RamsesKlap/FinalThesis/Lõputöö/Mõõtmed.md

# Jitter ehk sageduse variatsioon
- Temp: u 29kraadi
- Mõõtmise pikkus: 5 min
- 1. sagedus: 440-441 Hz ca C4
- 2. sagedus: 1864 Hz ca A#6
- 3. sagedus: 20 Hz

# Note on/off speed
- Temp: sama
- Mõõtmisi: 25
