RamsesKlap/FinalThesis/Lõputöö/Koosolekud/K7 - 09.09.25.md

Vaata üle mis skaalal oli PWM sisend VCO-l
Pane pote ENV 1 ja 2 otsa, et saaks ilma ADSRita proovida

Teaduste öö olla kaks viimast töötuba, 14+ vanus

### Õppeassistent
- E-lab
	- date peaks olema 21. sept
- Nimeta LABid üle uut moodi
- Lab1
	- küsimuste vastamise vaata üle, et see töötaks
	- Saab korduvalt vastata
	- Punktisummad
	- Pane küsimused eraldi lehtedele ka

880
860
840
293.3
286.6
280
