RamsesKlap/FinalThesis/Lõputöö/Elektroonika/VCO.md

#Siinus #Nelinurk #Saehammas #Kolmnurk #Summeerimine 

------------------
# Signaaligeneraator
*Miks?*
- Selleks, et heli tekitada
- nö südamik

*Millised?*
- **Kokku:** 10
- Siinus+
- Kolmnurk+
- Saehammas+
- Nelinurk+
- **Kombod:** 
	- Siinus + Kolmnurk+
	- Kolmnurk + Saehammas+
	- Saehammas + Nelinurk+
	- Nelinurk + Siinus+
	- Siinus + Saehammas
	- Kolmnurk + Nelinurk+
	- Valimine toimub [[Waveform Select]]is

*Valikud:*
- [AS3340](https://www.ericasynths.lv/shop/ics/voltage-controlled-oscillator-as3340/)
	- *5 €/tk* (SOIC) või *10 €/tk* (PDIP)
	- All-in-one (va siinus)
	- Temp. stabiilsus hea
	- Töötab kahepolaarse toitel
	- Läti toode :D
	- *Signal amplitudes*
		- Triangle - 1/3 of the supply (12 V -> 4 V)
		- Sawtooth - 2/3 of the supply (12 V -> 8 V)
		- Pulse - 1,5 V below the supply (12 V -> 10,5 V)1
# Coarse + Fine tuning
+ Kasutada digitaalpotentsiomeetreid, et saaks softis seda reguleerida
+ Lisab "manual override" juhul kui see ei tööta nii hästi

----------
### Signaali suund: [[Waveform Select]]
