RamsesKlap/FinalThesis/Lõputöö/Koosolekud/Küsimused.md

**LFO**
- Kas kombineerida LFO kiirus ja amplituud ühe rotary encoder peale või mitte?

**VCO**
- Kas rotary encoder + binary counter + mux on mõistlik signaalide valimiseks?
- Kas clocki delay-ima mingil määral, et kindlaks teha, et D on on seadustatud enne clocki tõusmist?
- Kas oskad midagi rääkida OTA-dest? Kas on mõistlik valik? (LM13700)

**Misc.**
- Kas on mõistlik lisada digipoted ja tavalised poted asjade reguleerimiseks (nt häälestamine, pitch bend jne), et oleks võimalik seda softis ja manuaalselt muute?

## K7 küsimused
- Ma leidsin Erica Synths-i poolt koostatud ADSR, VCF, VCA ja VCO kiibid, mis tunduvad päris head. Kas kasutada kõike või ainult näiteks VCA ja VCO-d?
	- [VCF](https://www.ericasynths.lv/shop/ics/voltage-controlled-filter-3109/)
		- Sama arhitektuur kui see MS-20 filter
		- Saab kahte kanalit ühe kiibi alla panna
		- 2xOTA on *0,99 €/tk* (LM13700) ning kiip ise on *4,50 €/tk*
		- Kas see kiip oleks soodsam/mõistlikum kui ise kokku panna?
	- [VCA](https://www.ericasynths.lv/shop/ics/voltage-controlled-amplifier-as3360/)
	- [ADSR](https://www.ericasynths.lv/shop/ics/voltage-controlled-envelope-generator-as3310/)
