RamsesKlap/FinalThesis/Lõputöö/Koosolekud/K6 - 17.06.25.md

Jaga Kaiserile skeemid zipidena

Lugemiseks kui viitsin:
- PCB Stackup (4&6 kihilistele)
- Via stub
- Return path
- Gnd via signaali via kõrvale, et ta sidestuks sellega

Kirjelda board stackupi aruandes

Proovi mõningaid asju jätta projektiainete jaoks

# Õppeassistent
- Drag and drop image asi toiteploki jaoks
- 0.25 ühikutrahv
-
