RamsesKlap/FinalThesis/Lõputöö/Koosolekud/K1 - 20.11.24.md

Vaata tugipingeallikaid, mis oleksid sweetspotis

Toide oleks pigem parem võtta AC-AC adapter, kui vool on suurem kui 10-20 mA
Kui väiksem, siis saab virtual groundiga

Talle väga meeldis, et ma standardist rääkisin :)

DACi sampling frequency kohta võib uurida hiirte kohta ja nende sagedustest
