RamsesKlap/FinalThesis/Lõputöö/Koosolekud/K3 - 17.03.25.md

*Elektroonika*
- MCU võta pigem 10 pinine kõige rohkema mäluga
	- Vaata äkki panna samale boardile 64 ja 100-ne (footprindid üksteise sisse nt)
	- Vaata mehaanilist mõõtu esialgu ja siis pinout
- DAC ja ADC valiku uurimine
	- Kas piisavalt kiire / hea sampling rate?
	- Teegid?
- Alusta "interface" blokkist
- Toide
	- Tee eraldi toite flowchart
	- Vaata kas asjad saaksid kaetud (teoorias)

## Elektroonika aine
6 ja 7 enesekontrolli testid
- Teen küsimused juurde äkki
Lab1 ja 2
- Proovida neid läbi koos juhenditega
- Mis puudu, mis võiks paremini teha?
