RamsesKlap/FinalThesis/Lõputöö/Koosolekud/K4 - 07.04.25.md

# ADC
- Vaata mis mõjutavad sampling rate'i (toitepinge, temperatuur vms)
	- Sampling rate ei ole muidugi ideaalne, mingid parameetrid sellel ongi
- Vaata äkki mingi aeglasem variant ka
	- Pane PCB-le kaks ADC-d. Üks kiirem üks aeglasem
- Uuri kas äkki kasutada lihtsalt 1 ADC per membrane (eraldi)

# DAC
- Vaata kas keegi tahaks teeki teha selle uhke teegi jaoks nt lõputööks

## Misc.
- Testi thinpoti reageerimist ja kas see teeb open connectionit
- Uuri FPGA-d
## Soovid
- Vaata, et liiga paljuks ei lähe
