RamsesKlap/FinalThesis/Lõputöö/Koosolekud/K5 - 03.06.25.md

# Uuri
- Lag / Jitter / Faas
	- Kuidas mõõdame?
	- "Propagation delay"
	- Tee terminoloogia selgeks
	- Kuidas tuvastada / mõõta?
		- Kvantitatiivselt suuta asjad paika panna
	- 

Hea et uurisin reageerimisaegu reageerimisaja kohta. Sellest võiks töös rääkida.

# Gantt
- Suur tükk ajab suu lõhki
- Dets / Jaanuar **Riisvara võiks olla küps**
- Võibolla mõelda, mis on ülikriitiline mida lahendada
- **Color Coding vastavalt diagrammile**

Alati kui mingi valiku teen, siis see peab mingi alusel olema selgitatud
Kriteeriumid!!!

Pane plokki alla alamplokkid

Kirjutada Ellervee / Eekile kas keegi tahab teeke kirjutada

Pane plokkskeem excelli

MVP - Sisend, VCO ja VCA
Baka töös pmst fokuseerida nendele vist

1. sissejuhatus
2. State of the art
3. Simukad / Valikute põhjendamine / Trükkplaadi v Skeemi tegemine
4. Mõõtmine
5. Kokkuvõte

Koosolekud võiks teha 2 nädalaste vahedega

# Aniõppejõud
- Sandbox
	- Finalize
	- Laborite osas peab tekkima 4
	- Edenemisskaalad eraldi teha (Nagu elektroonikas)
- Juhendid
	- Eestikeeles juhendid olemas
	- Inglisekeeles pole
	- Võiksin esmase tõlke teha nende jaoks
		- e-lab
		- arduino
			- Võiks sellele teha vormi, millele vastavad aruannet lugedes
			- Moodle'i vormi selles suhtes
		- Diood ja transa labor
			- Ideaalselt samasugune labor
		- Opvõimendi laborid
		- Jootelabor
