RamsesKlap/FinalThesis/Lõputöö/Koosolekud/K2 - 10.02.25.md

# Rotary encoder selector
- Deboucer lisada
## Asjad mida teha
- Võta ette lõputöö mall
- Oma nägemuse järgi pane peatükkitele nimed
	- ala state of the art
		- Lõppu üleasande/probleemi püstitus
		- 2-3 lauset mis paneb selle paika
		- "Tehti nii, ma teeks nii/muudaks seda"
	- sims
	- skeem 
	- riistvara
	- kood
	- testimine
	- kokkuvõte
	- jne
- Hakka väikest mulli looma
- Vb uuri mis riistvara enam vähem paigas (nt prose)

# Toide
- Uuri low noise teemat
- Uuri trafosid ja olemasolevaid lahendusi
