RamsesKlap/FinalThesis/KiCad/ModulinV2/ModulinV2_amounts2.csv

Qty | Value
107 | 100n
71 | 1u
2 | 2p
4 | 2u2
13 | 10n
13 | 3n
2 | 22p
3 | 1m
4 | 100u
1 | CDBU0530
4 | 1N4148WT
2 | 1N5822
1 | SF-1206F100-2
6 | TL074HIDR
1 | STM32F401RET6
1 | USBLC6-2SC6
7 | TL072HIDR
2 | ADS7041IDCUR
2 | ADS7866IDBVT
2 | DAC60501ZDGSR
2 | AS3340D
3 | SN74LV10ADR
2 | SN74HC193DR
3 | TMUX4051DYYRQ1
1 | NC7SZ74K8X
3 | SN74AHCT1G00DBVR
2 | SN74AHC1G02DBVR
1 | TMUX4052DYYR
2 | E-ULN2003D1013TR
2 | CD4028BM96
1 | AS3360D
1 | REF196GSZ-REEL
2 | NCP5500DADJR2G
2 | LM2576S-12_NOPB
1 | REF195ESZ-REEL
2 | L7812CD2T-TR
2 | AS3310D
1 | DAC53202RTER
2 | AS3320D
1 | NRJ4HF-1
1 | USB4105-GF-A
1 | TSM-103-01-T-DV
1 | TSW-104-07-G-S
4 | TSW-104-07-T-D
1 | PJ-002B
1 | Output bypass1
1 | Output bypass2
2 | ADSR_BYPASS1
1 | OLED_PWR
2 | Pot GND
2 | Attack override
2 | Decay override
2 | Sustain override
2 | Release override
1 | VCF_BYPASS1
1 | VCF_BYPASS2
2 | 68u
2 | 20u
1 | 150212M173123
14 | 150060RS75000
4 | 150060VS75000
2 | MMBFJ201
1 | DMP610DL-7
41 | 10k
24 | 100k
6 | 5k1
28 | 1k
14 | 20k
2 | 200k
11 | 1M
14 | 470
2 | 360k
1 | 1M5
2 | 24k
2 | 5k6
2 | 620
2 | 2k4
4 | 1k2
2 | 220k
4 | 47k
8 | 2k
2 | 30k
6 | 22k
6 | 51k
2 | 68k
2 | 1k8
2 | EXB-2HV102JV
2 | TL3365AF180QG
2 | PEC12R-3220F-S0024
2 | EG4208A
1 | OS102011MS2QS1
1 | SW_SPDT_MSM
1 | Rocker Switch
1 | BendTop
1 | Final
1 | VBUS
1 | ENCA
1 | SDA1
1 | SCL1
1 | SDA2
1 | ENCB
1 | SCL2
1 | CLK2
1 | MOSI2
1 | CS2.1
1 | CS2.2
1 | CLK1
1 | MISO1
1 | CS1.1
1 | CS1.2
1 | CLK3
1 | MISO3
1 | MOSI3
1 | CS3
1 | Press1.1
1 | Pitch1
1 | Pitch2
1 | Press1.2
1 | Pot1
1 | Pot2
1 | Gate1
1 | Press1.3
1 | Press2.1
1 | Press2.2
1 | Gate2
1 | Press2.3
1 | +2V
1 | +1V
1 | SW1
1 | SW2
1 | +4V
1 | +3V
1 | Oct
1 | !Q
1 | Enc_B
1 | Q
1 | Up
1 | Down
1 | Enc_A
1 | Wave1
1 | VCA1
1 | Wave2
1 | VCA2
1 | 3v3
1 | 3v3A
1 | VDC
1 | +12V
1 | -12V
1 | 5V
1 | 5VA
1 | ADigital
1 | DDigital
1 | SDigital
1 | RDigital
1 | Attack
1 | Decay
1 | Sustain
1 | Release
1 | ENV1
1 | ENV2
1 | C1Digital
1 | C2Digital
1 | F1Digital
1 | F2Digital
1 | Coarse1
1 | Coarse2
1 | Fine1
1 | Fine2
1 | LFO1
1 | LFO2
1 | LFO_INV
1 | LFO
1 | VCF1
1 | RES1
1 | CUT1
1 | RES2
1 | VCF2
1 | CUT2
1 | SN74AHC1G08DBVR
1 | PTA4543-2015CPB104
1 | PTA4544-2015DPA103
10 | PTV09A-4025F-B104
8 | DS3502U+
2 | PTV112-4420A-B104
1 | CX2016FB24000B0FZZH1
