RamsesKlap/FinalThesis/KiCad/ModulinV2/Footprints/MCU/STM32F401VET6/LQFP100-14x14mm.step

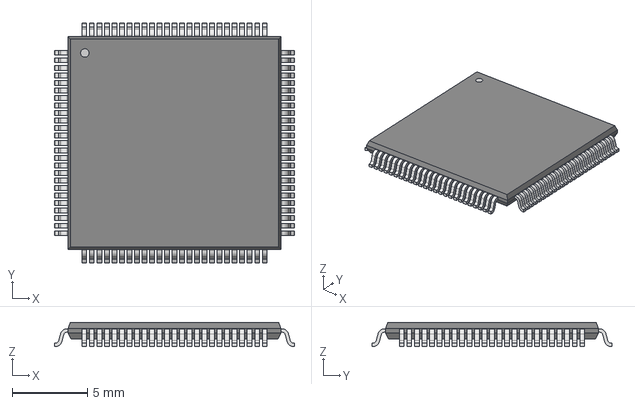
[picture p1: CAD file, 2025-04-27]
KiCad/ModulinV2/Footprints/MCU/STM32F401VET6/LQFP100-14x14mm.step
16.0 x 16.0 x 1.60 mm
