RamsesKlap/FinalThesis/Measurements/20Hz_jitter_1.png

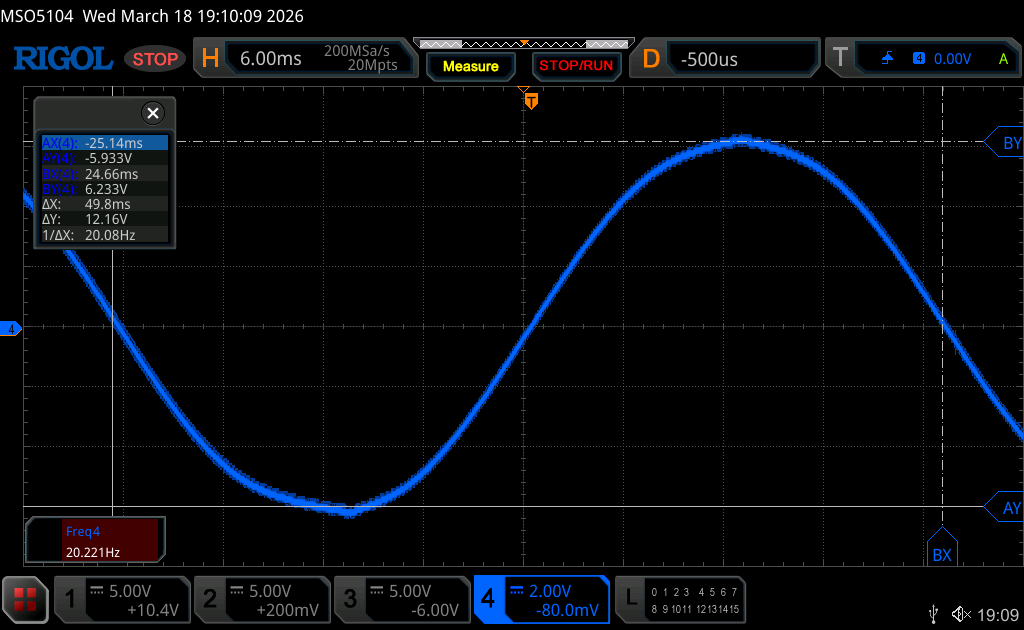
Measurements/20Hz_jitter_1.png
