RamsesKlap/FinalThesis/Measurements/A#6_jitter_1.png

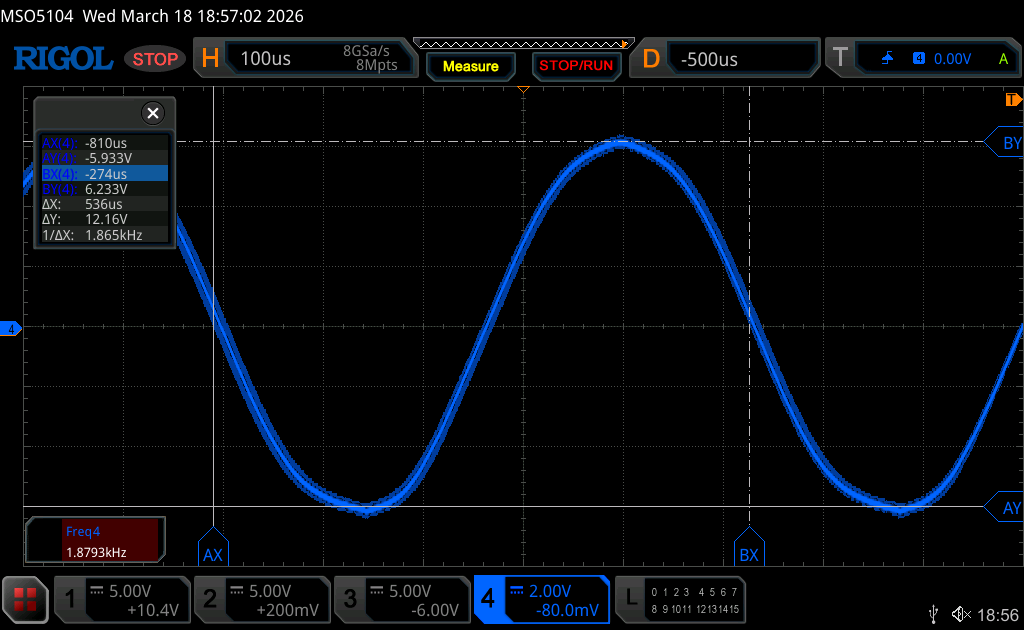
Measurements/A#6_jitter_1.png
