RamsesKlap/FinalThesis/Measurements/C4_jitter_1.png

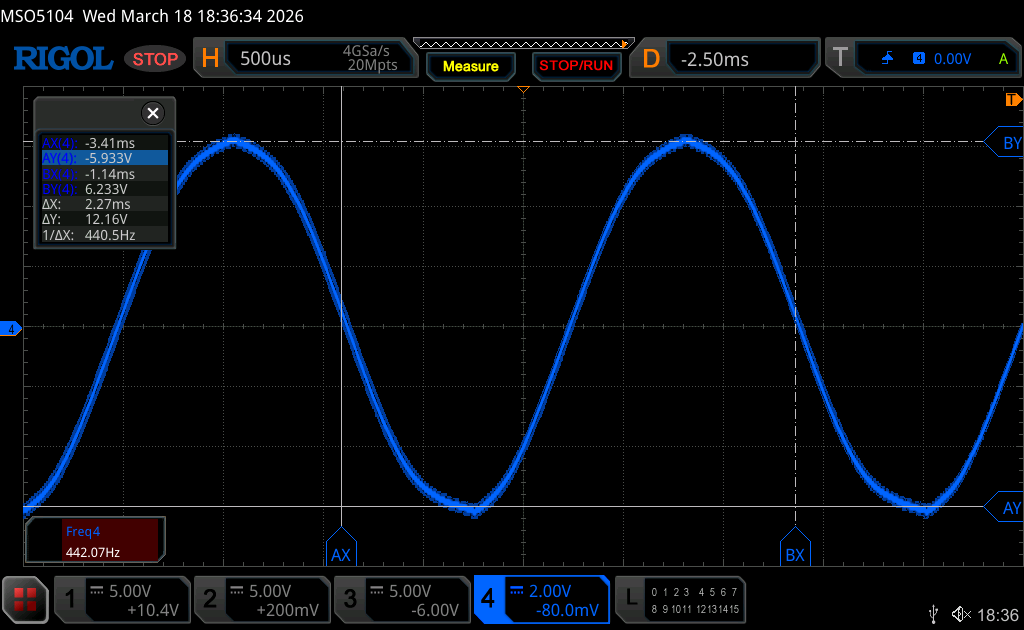
Measurements/C4_jitter_1.png
