RamsesKlap/FinalThesis/Measurements/C4_jitter_2.png

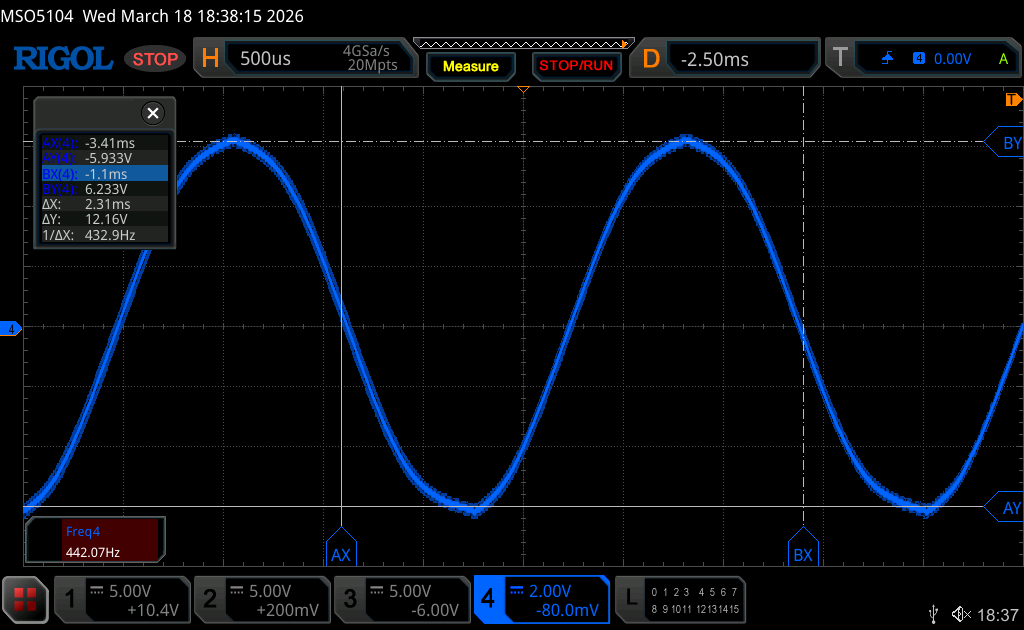
Measurements/C4_jitter_2.png
