RamsesKlap/FinalThesis/Measurements/Gate_To_Output.png

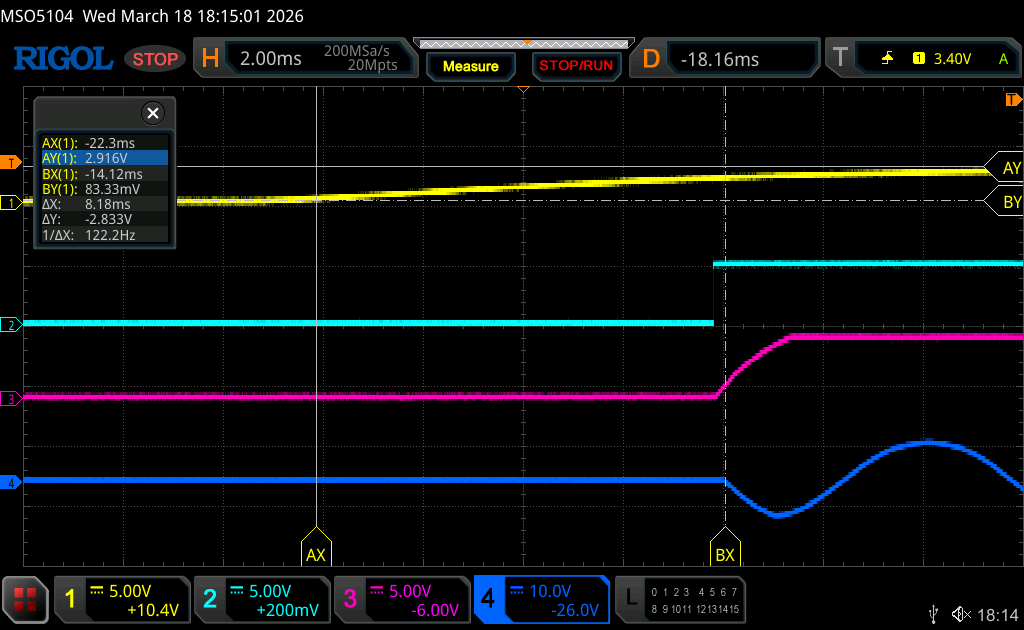
Measurements/Gate_To_Output.png
