RamsesKlap/FinalThesis/Measurements/in_to_out.png

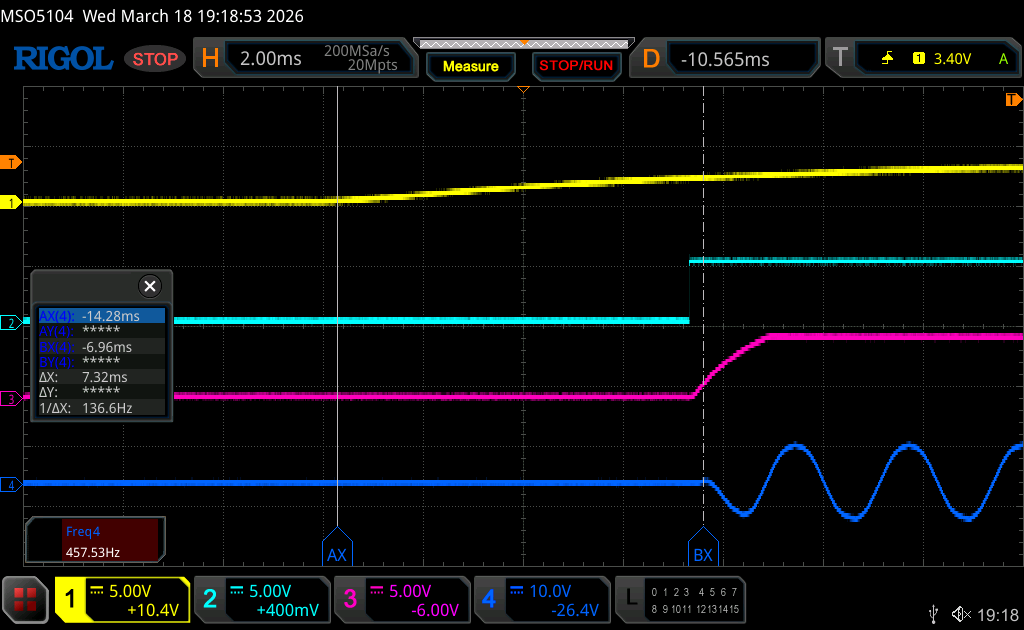
Measurements/in_to_out.png
