RamsesKlap/FinalThesis/KiCad/Schematic.pdf

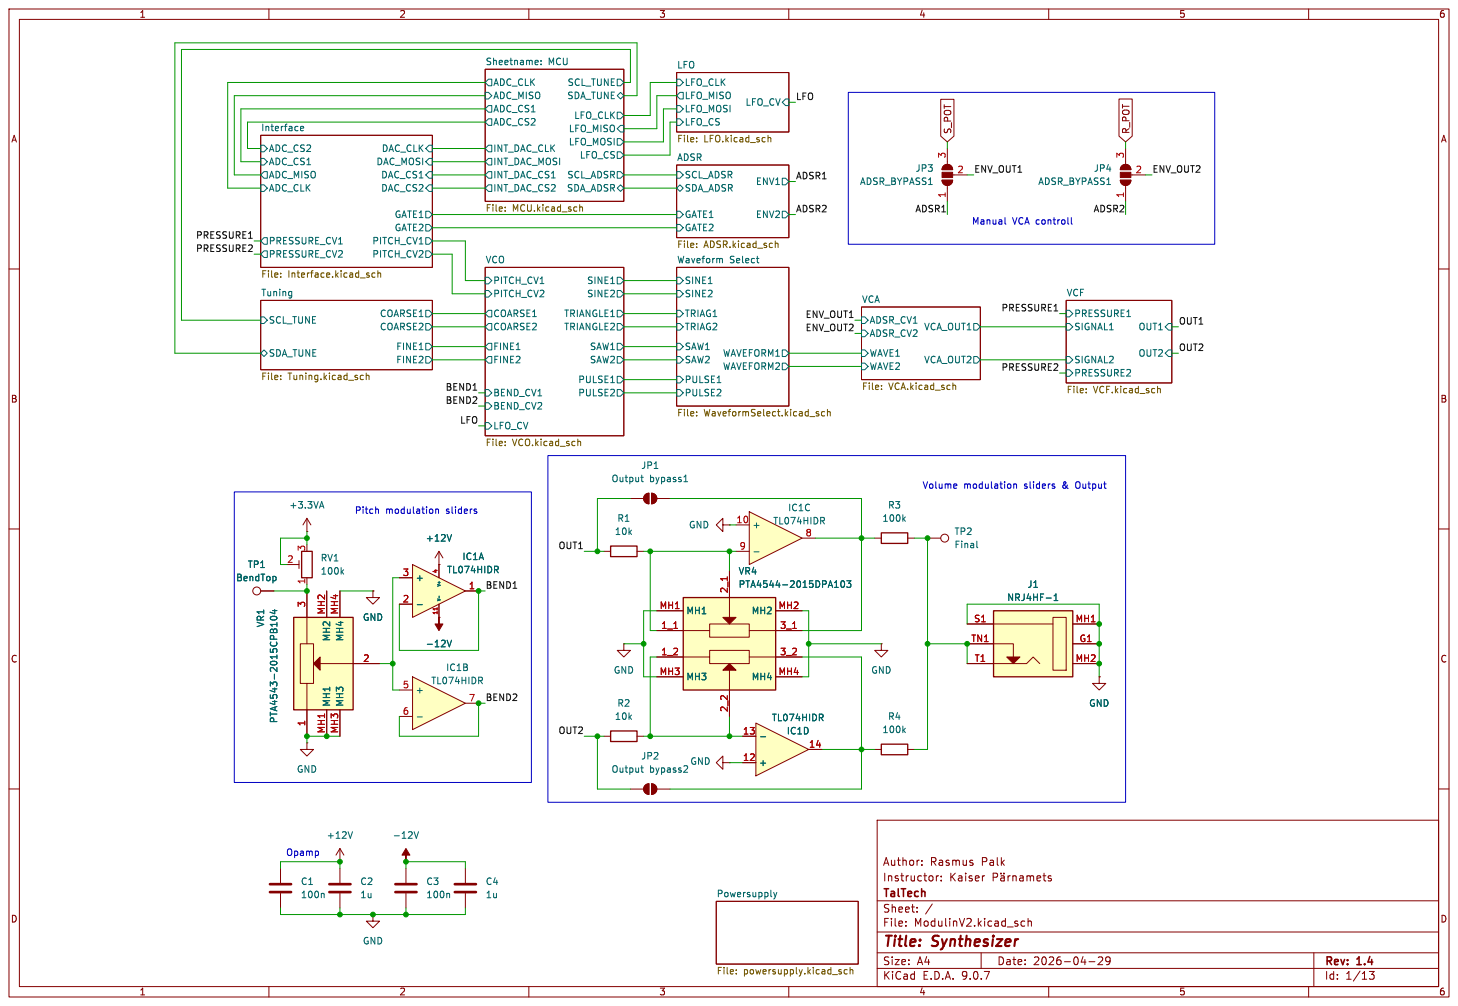
[picture p8: page 1]

Id: 1/13 Title: Synthesizer File: ModulinV2.kicad_sch Sheet: / TalTech

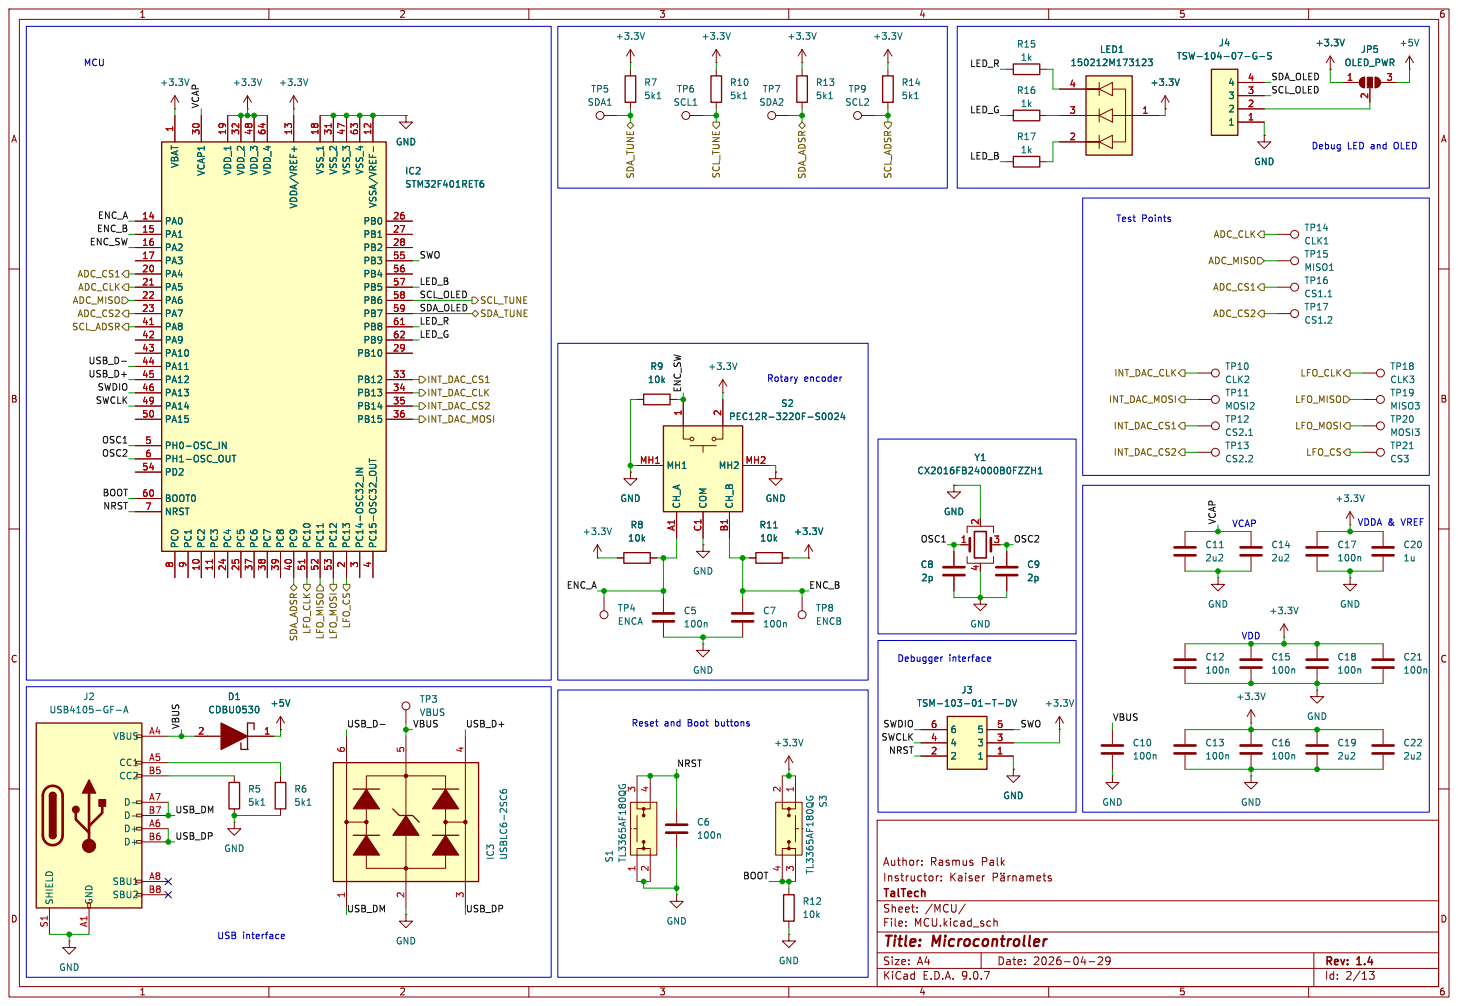
[picture p9: page 2]

Id: 2/13 Title: Microcontroller File: MCU.kicad_sch Sheet: /MCU/ TalTech

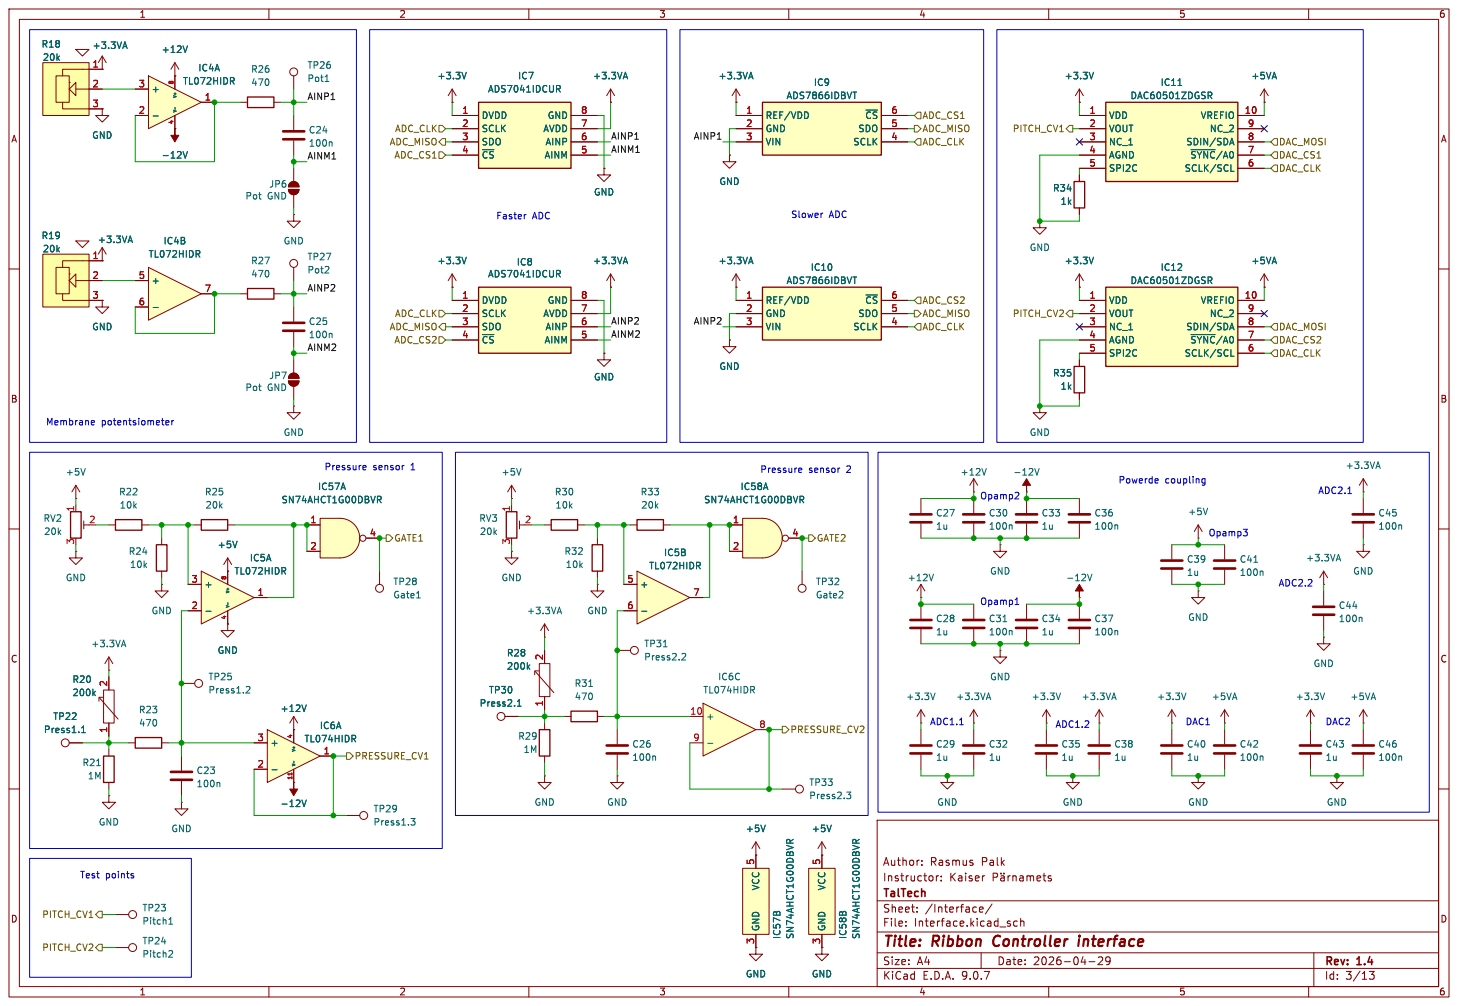
[picture p10: page 3]

File: Interface.kicad_sch Sheet: /Interface/ TalTech

Id: 3/13 Title: Ribbon Controller interface

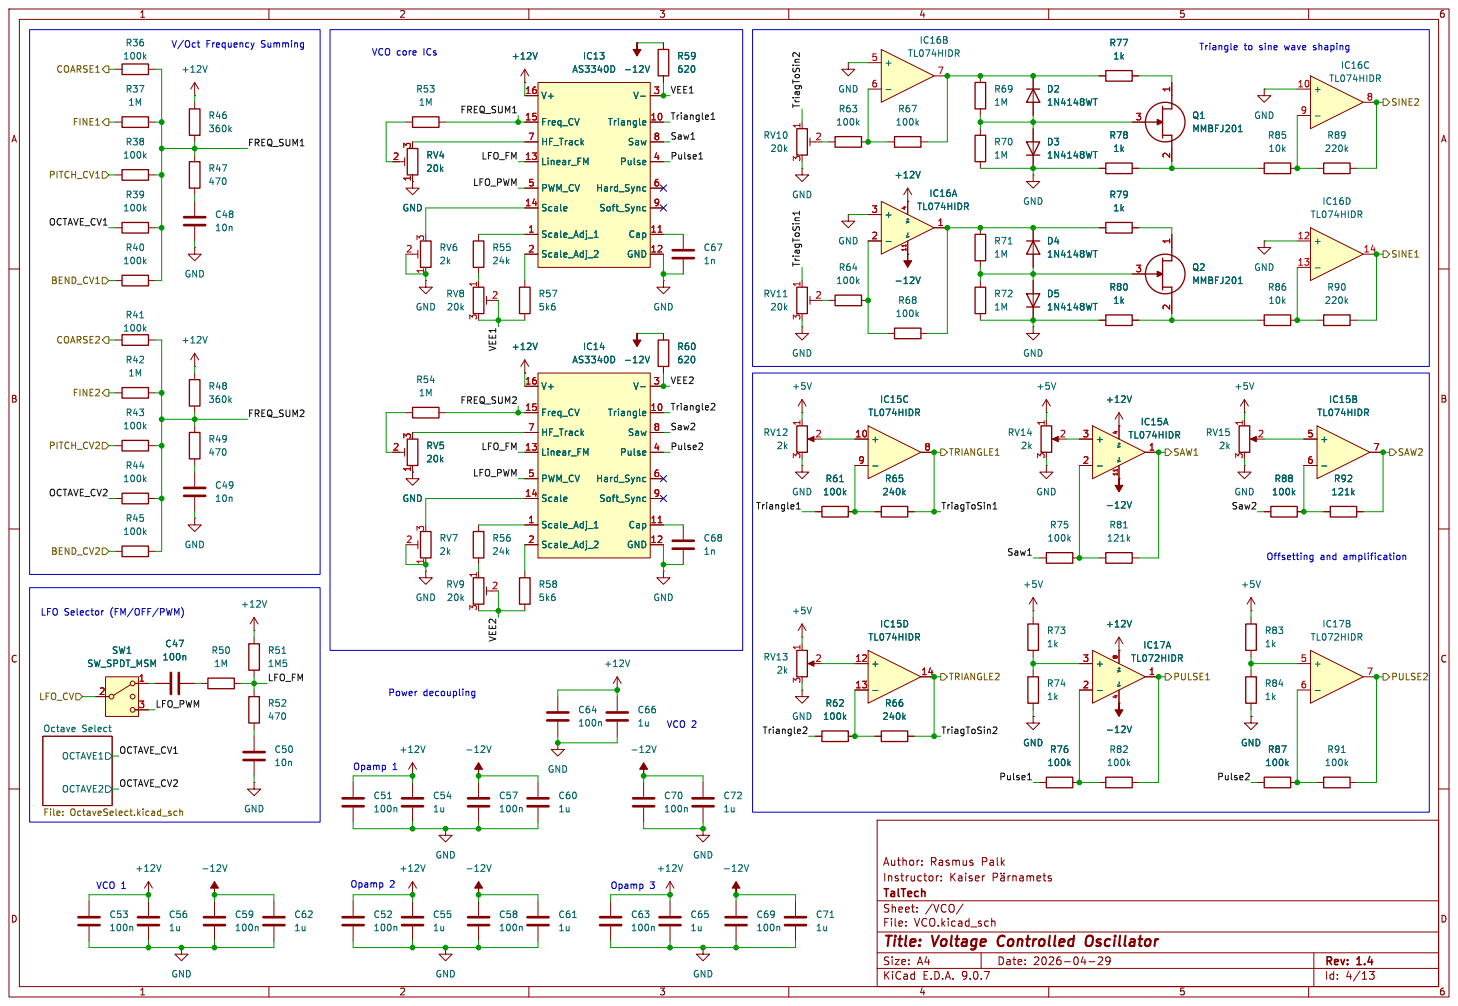
[picture p11: page 4]

Triangle to sine wave shaping SW1 SW_SPDT_MSM

Id: 4/13 Title: Voltage Controlled Oscillator File: VCO.kicad_sch Sheet: /VCO/ TalTech

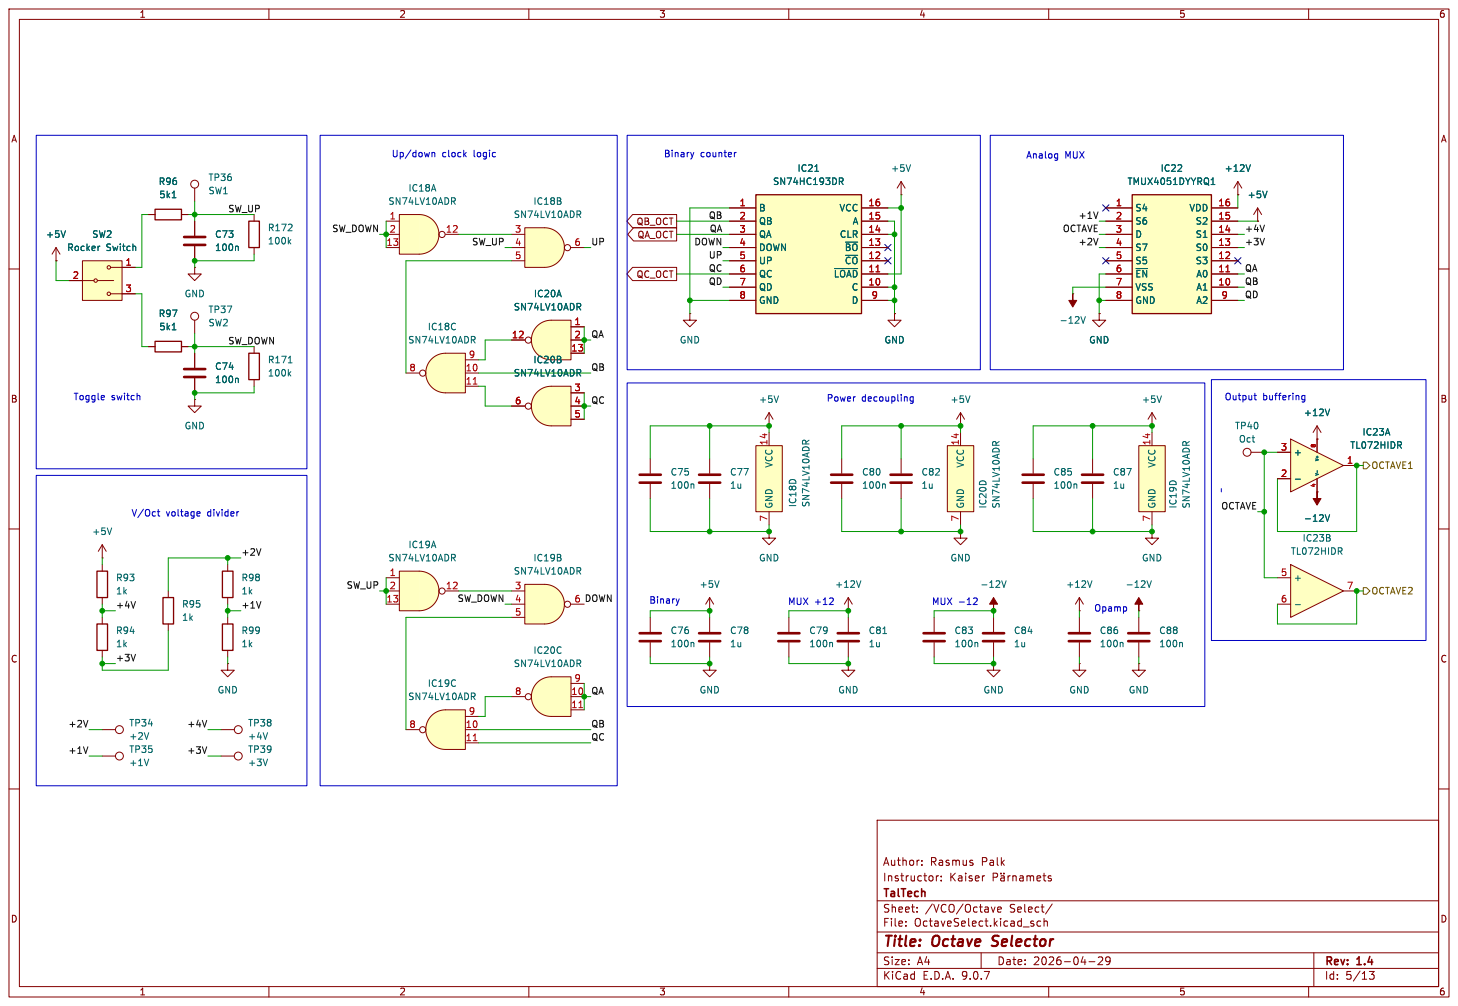
[picture p12: page 5]

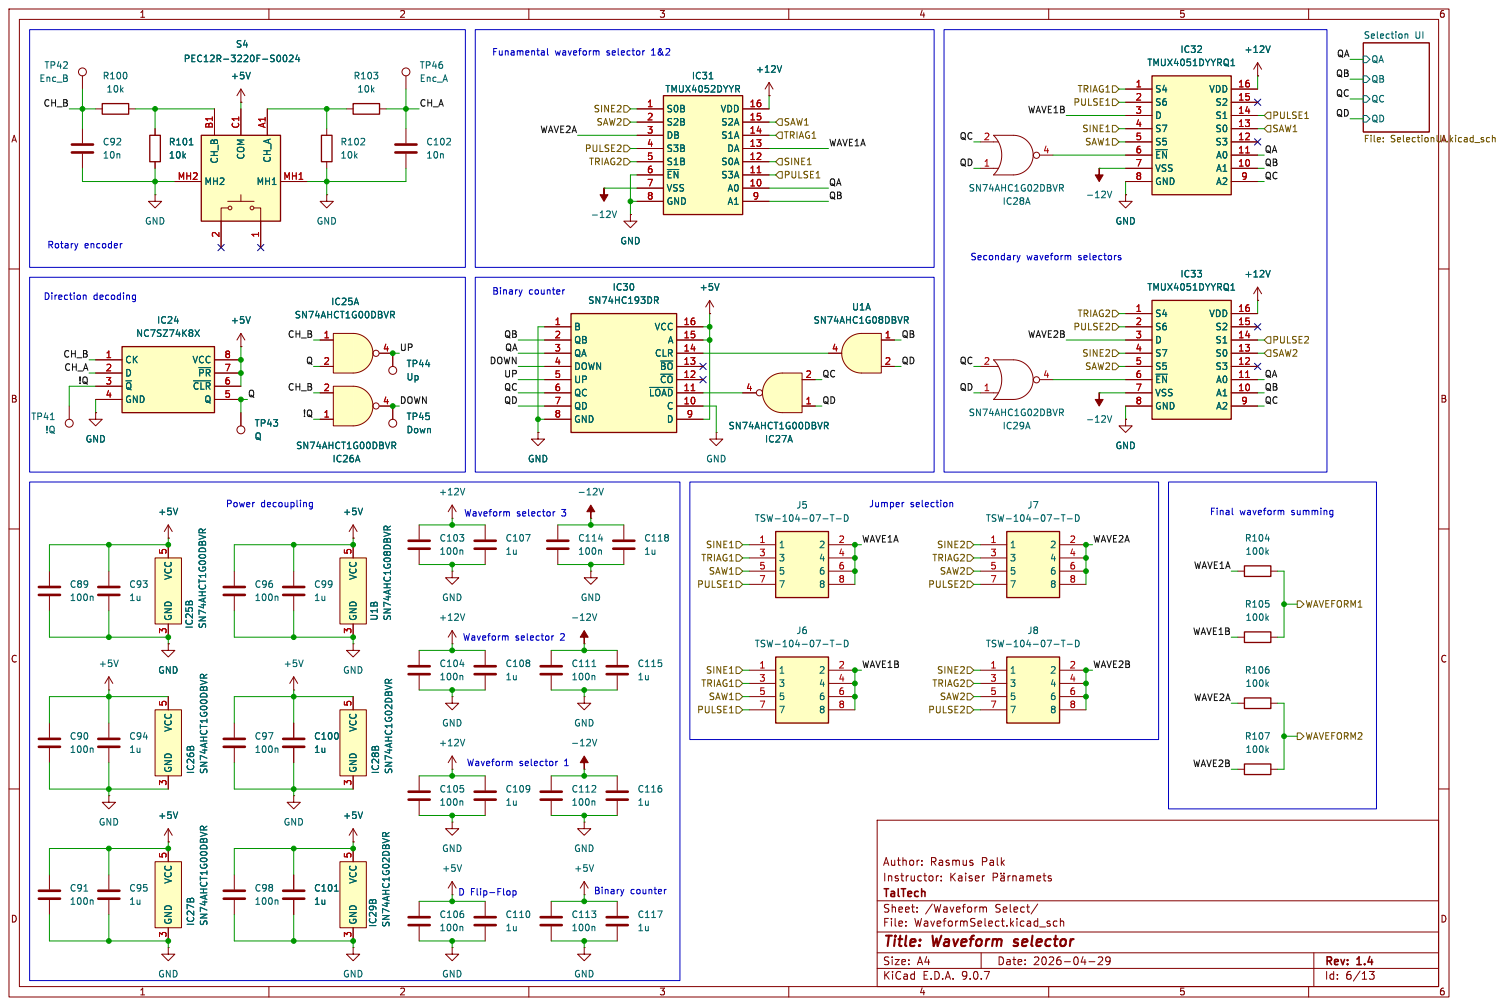
[picture p13: page 6]

15 CLR 14 ~{BO}13 ~{CO}12 ~{LOAD}11 C

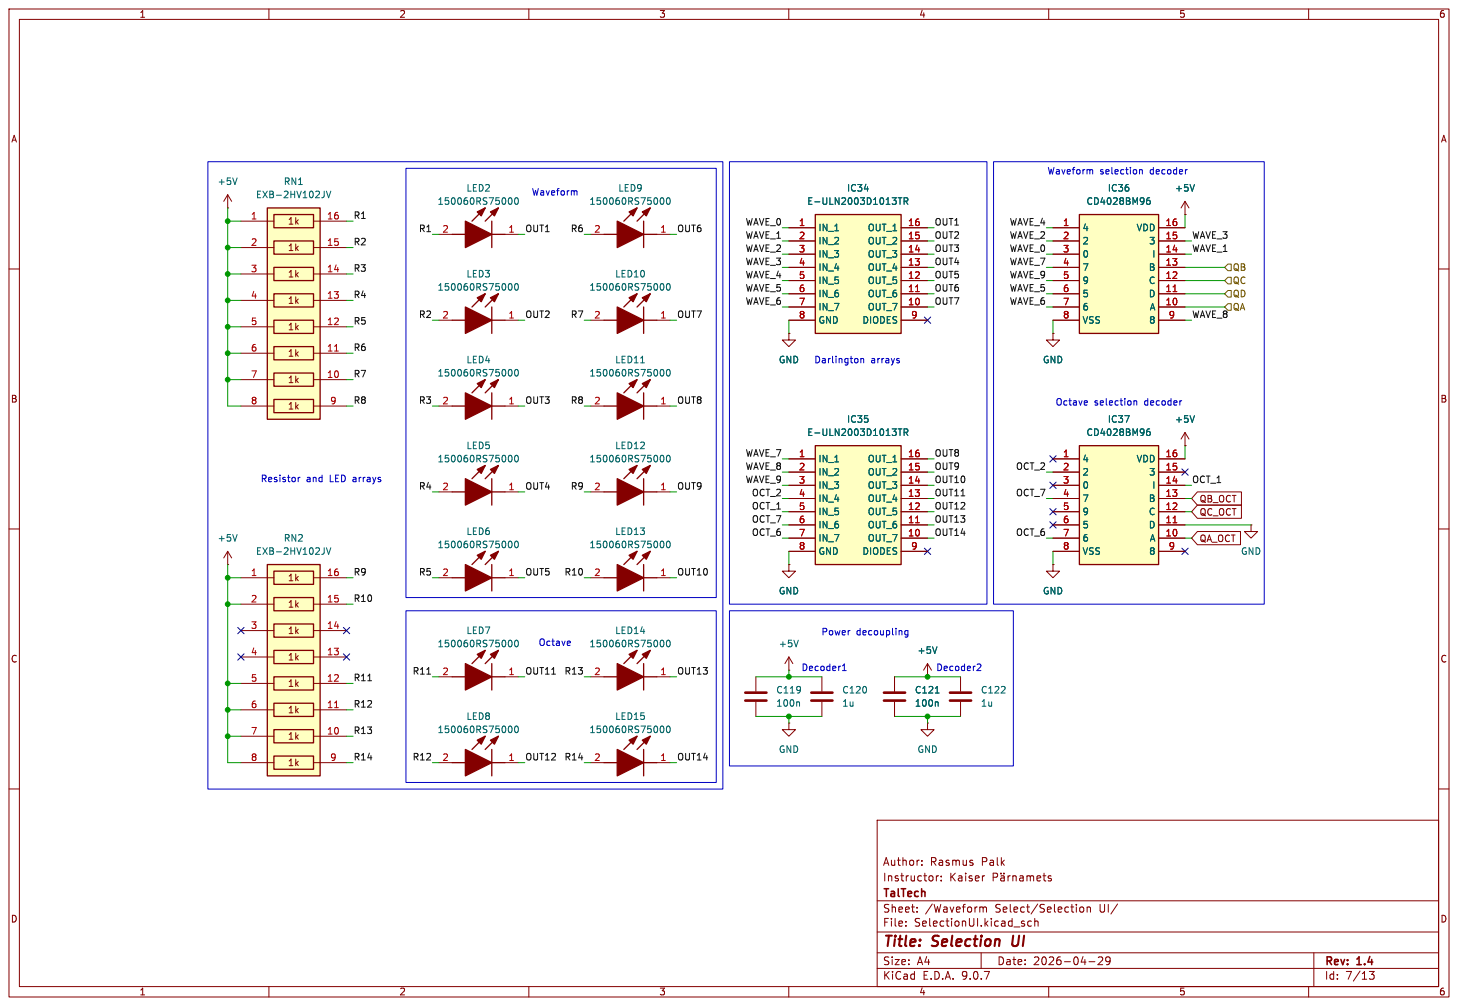
[picture p14: page 7]

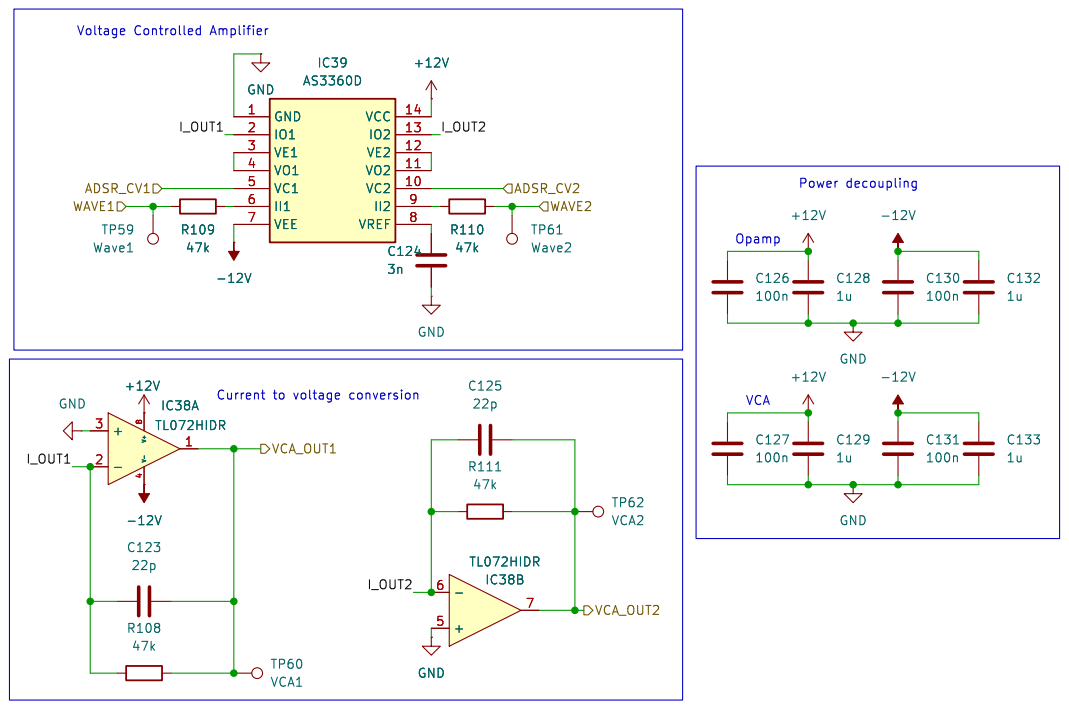
[picture p15: page 8]

Id: 8/13 Title: Voltage Controlled Amplifier File: VCA.kicad_sch Sheet: /VCA/ TalTech

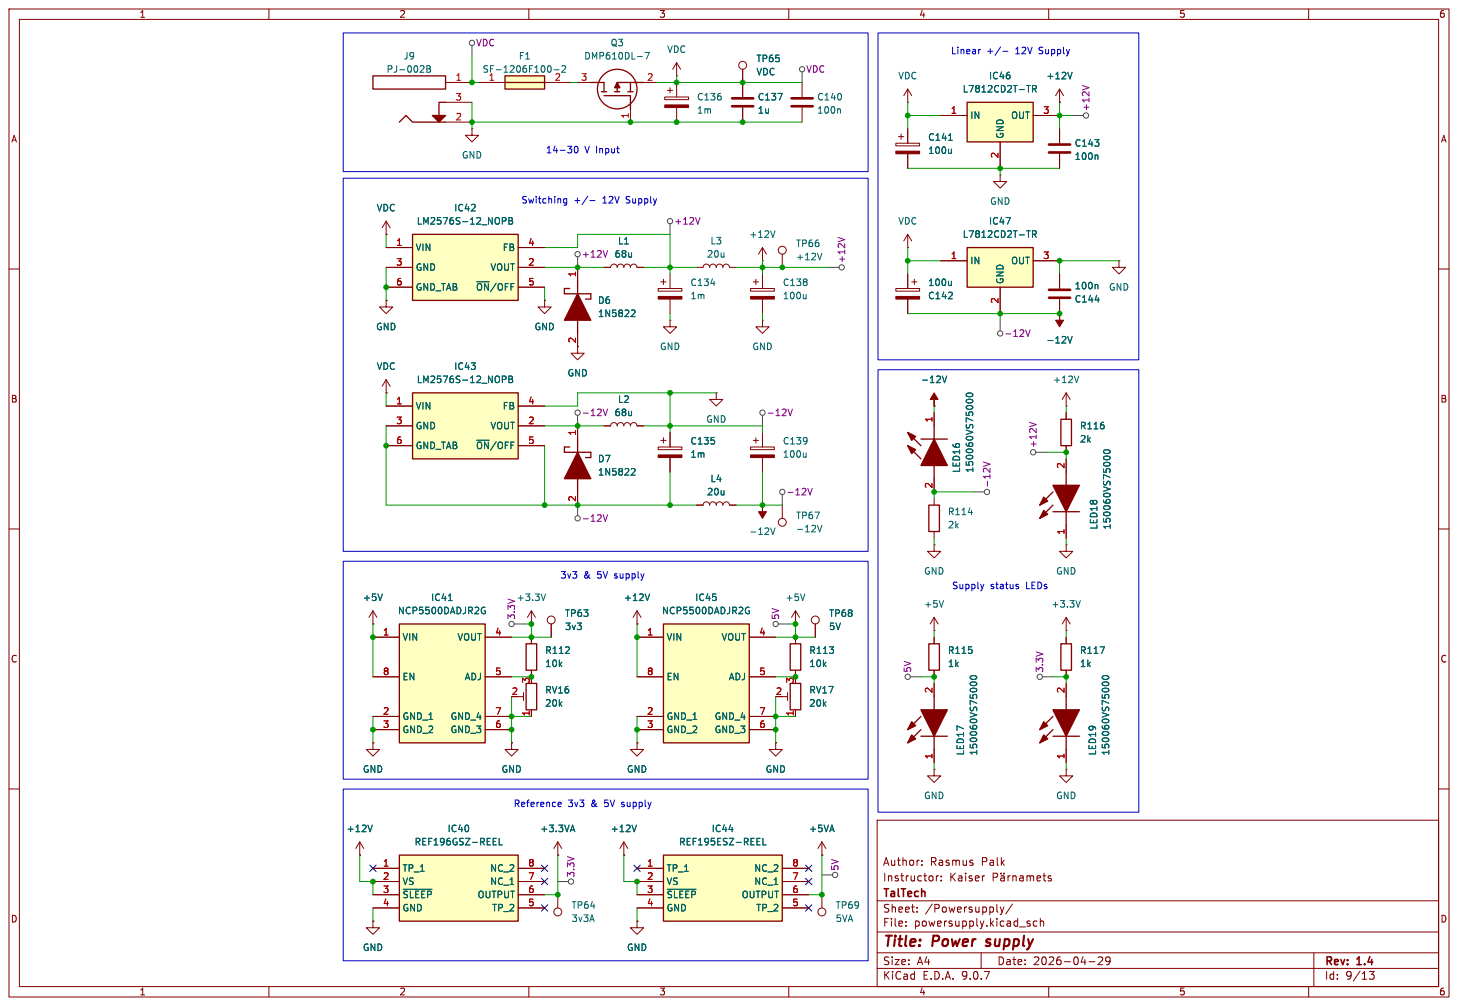
[picture p16: page 9]

File: powersupply.kicad_sch Sheet: /Powersupply/ TalTech

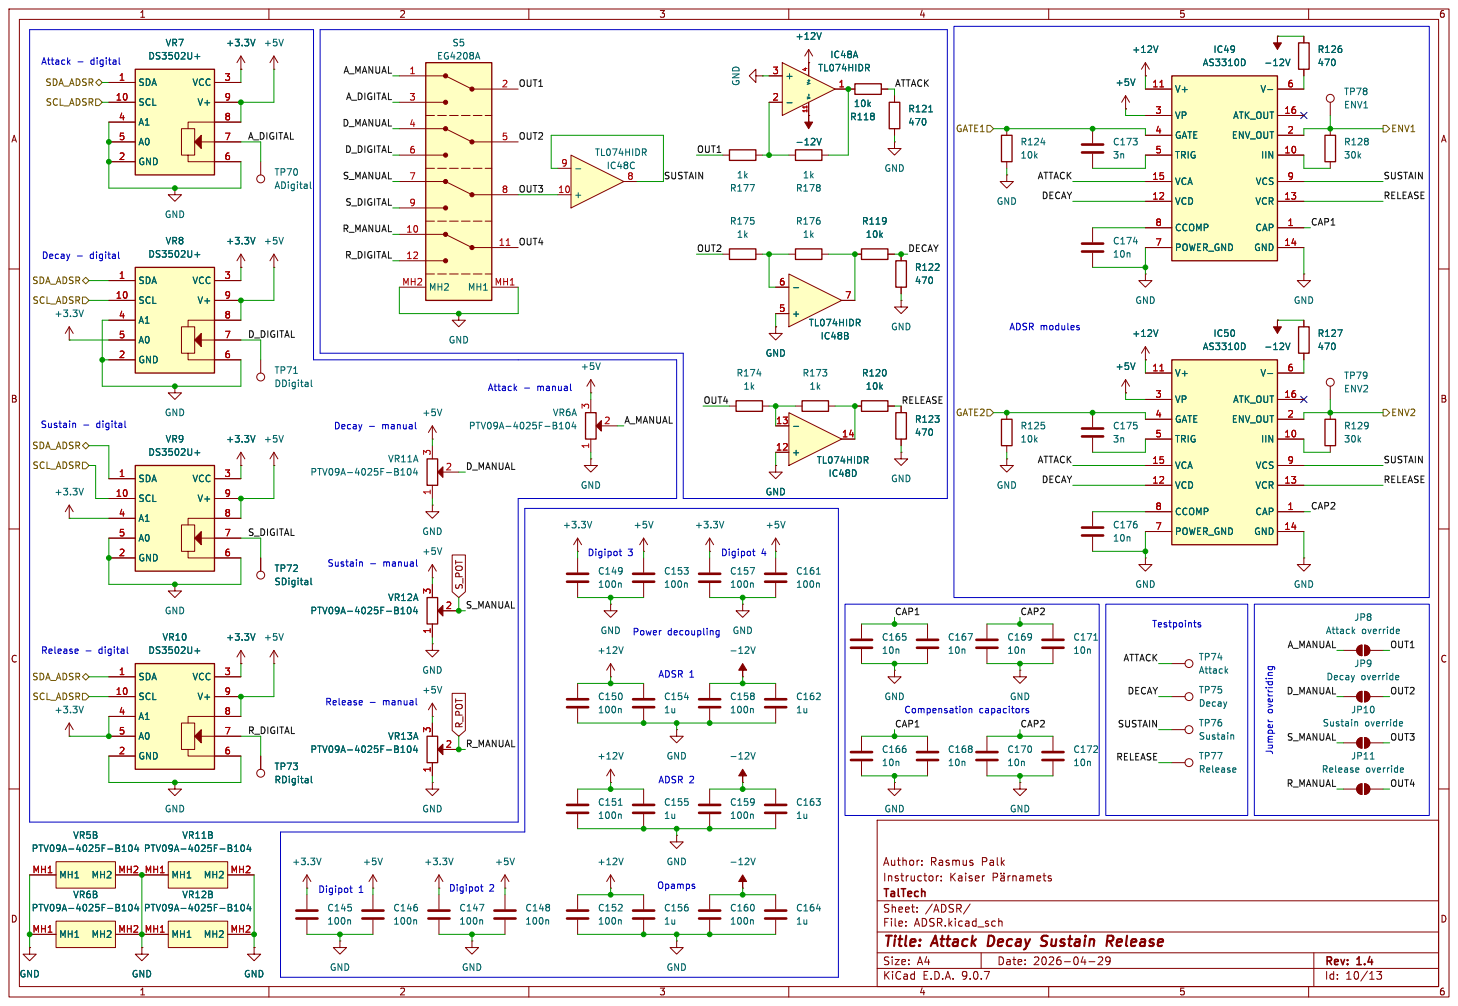
[picture p17: page 10]

Decay - digital Attack - digital

30k GND
TP79 ENV2 GND
ATTACK DECAY RELEASE DECAY

3 VR9 DS3502U+ SDA 1 SCL 10 A1 4 A0 5 GND 2 VCC 3 V+ 9

File: ADSR.kicad_sch Sheet: /ADSR/ TalTech

Id: 10/13 Title: Attack Decay Sustain Release

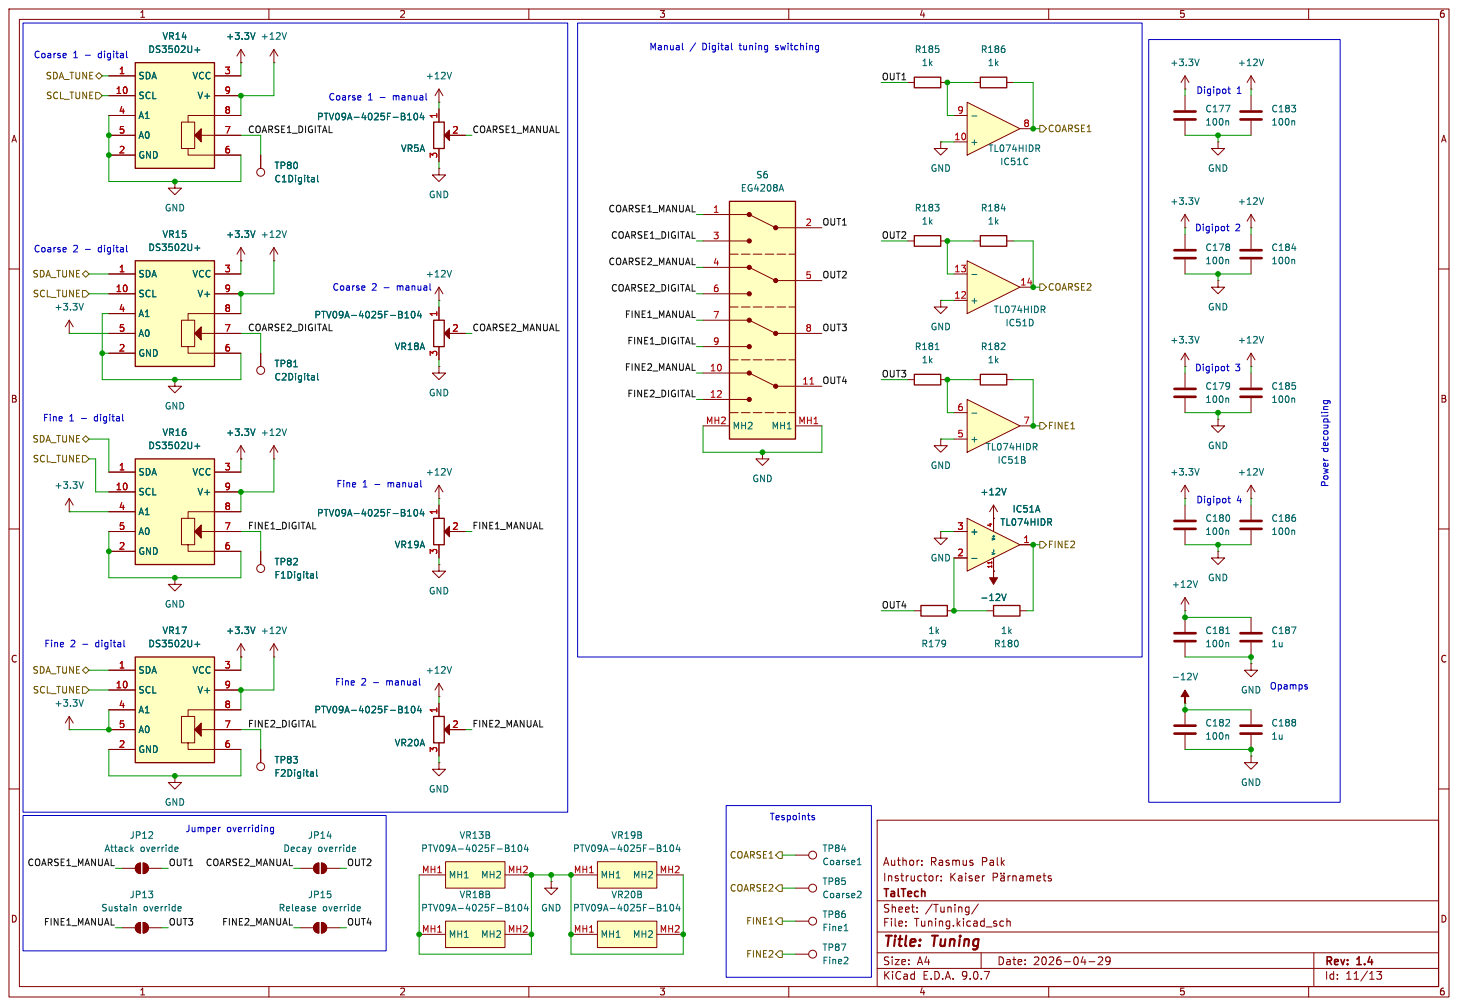
[picture p18: page 11]

3 VR15 DS3502U+ SDA 1 SCL 10 A1 4 A0 5 GND 2 VCC 3 V+ 9

File: Tuning.kicad_sch Sheet: /Tuning/ TalTech

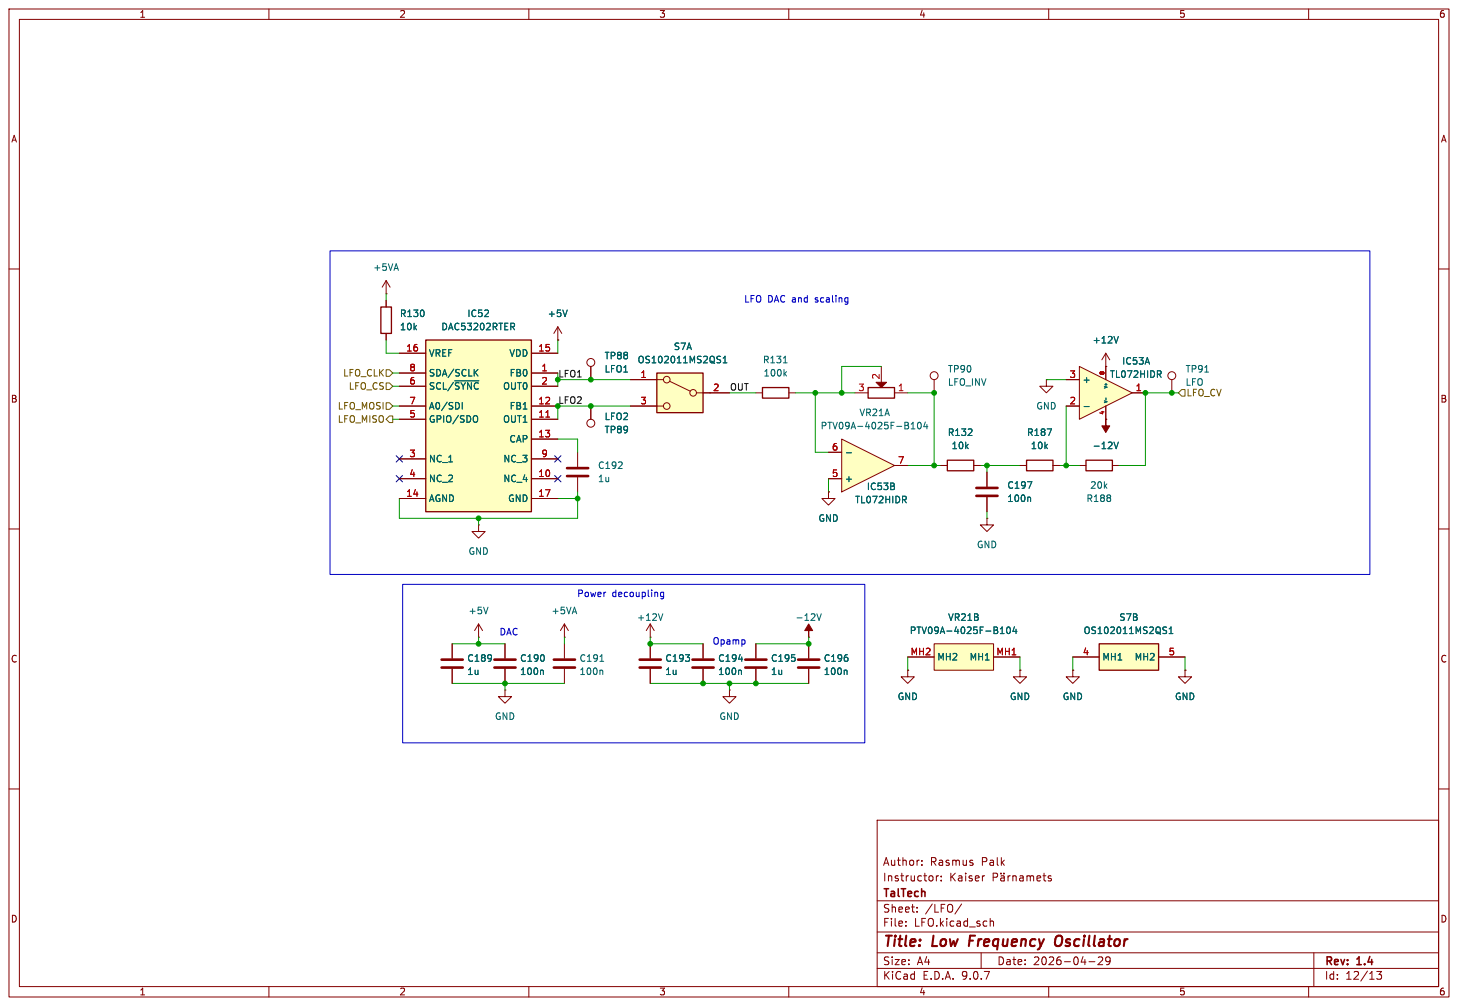
[picture p19: page 12]

Id: 12/13 Title: Low Frequency Oscillator File: LFO.kicad_sch Sheet: /LFO/ TalTech

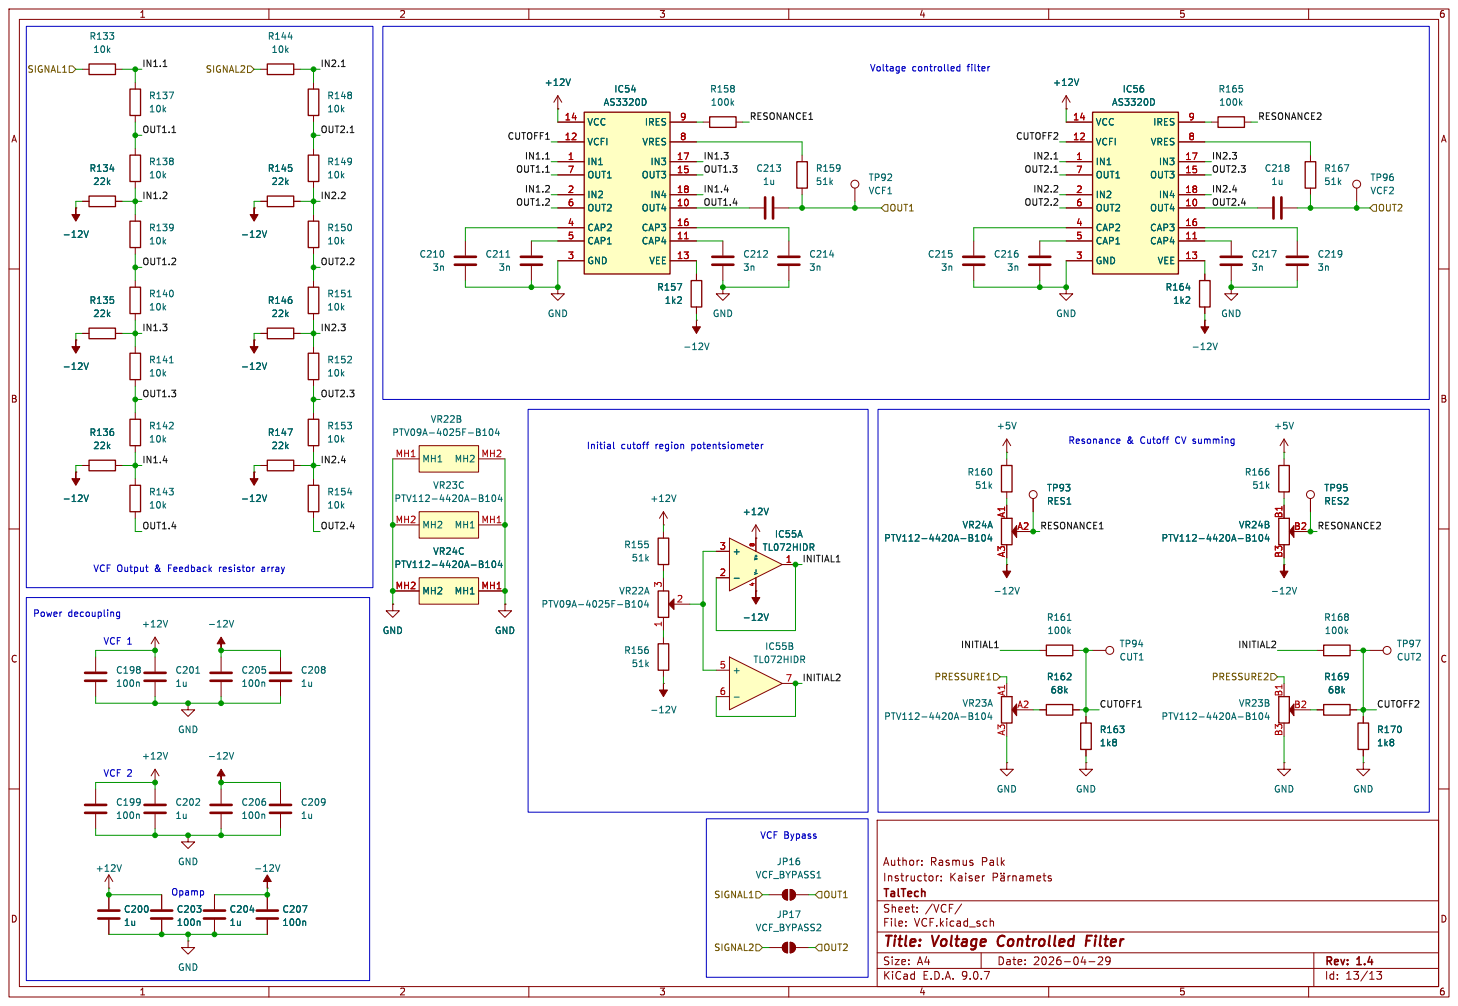
[picture p20: page 13]

Id: 13/13 Title: Voltage Controlled Filter File: VCF.kicad_sch Sheet: /VCF/ TalTech
