RamsesKlap/FinalThesis/CubeIDE/ModulinV2/Core/Src/main.c

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
/* Includes ------------------------------------------------------------------*/
#include "main.h"
#include "cmsis_os.h"
#include "usb_device.h"

/* USER CODE BEGIN Includes */
#include "ssd1306.h"
#include "ADS7866.h"
#include "DACx0501.h"
#include "DS3502UP.h"
#include "ssd1306_fonts.h"
#include "ssd1306_tests.h"
#include "usbd_cdc_if.h"
#include "usbd_def.h"
#include <stdio.h>
#include <string.h>
#include <math.h>
/* USER CODE END Includes */

/* USER CODE BEGIN PTD */

// For changing the "mode" of the output DAC
typedef enum {
  OCTAVE,
  OCTAVE2,
  MAJOR,
  MINOR
} scaleMode;

// So that which tuner we select is clearer to understand
typedef enum {
  COARSE1,
  FINE1,
  COARSE2,
  FINE2
} tuners; 

// Menu types for selecting in the UI
typedef enum {
  MAIN,
  TUNE,
  ADSR,
  INTERFACE,
  LFO,
  TEST
} page;

// States that the UI can be in
typedef enum {
  BROWSE,
  EDIT
} uiState;

// For showing which direction the encoder has been moved
typedef enum {
  UP,
  DOWN
} direction;

// For describing the goings on of the UI
typedef struct {
  page previousMenu;
  page currentMenu;
  uint8_t previousIndex;
  uint8_t selectionIndex;
  uiState state;
} menu;

// For dealing with encoder parameter changes
typedef struct {
  uint32_t lastCounterValue;
  int32_t parameterValueModifier;
  direction dir;
} encoder;
/* USER CODE END PTD */

/* USER CODE BEGIN PM */

// OLED Parameters
#define FONT Font_7x10
#define CURSOR_PAD 10
#define OLED_WIDTH 128
#define OLED_HEIGHT 64
#define MENU_IDX_MAX 4

// ADC output scale parameters for mapping the output to steps
#define MEMBRANE_MAX 4095.0
#define MEMBRANE_MIN 0
#define GAMMA 1.5

// DAC output value step for ~0.083V
#define DAC_HALFSTEP 136
// DAC output value step for ~0.166V
#define DAC_STEP 272
// DAC output value step for ~1V
#define DAC_OCTAVE 1638

/* USER CODE END PM */

I2C_HandleTypeDef hi2c1;
I2C_HandleTypeDef hi2c3;

SPI_HandleTypeDef hspi1;
SPI_HandleTypeDef hspi2;
SPI_HandleTypeDef hspi3;

TIM_HandleTypeDef htim2;

osThreadId userInterfaceHandle;
osThreadId ADCHandle;
osThreadId DACHandle;
osThreadId digiPotHandle;
osThreadId encoderHandle;
/* USER CODE BEGIN PV */

// For storing values into when printing to OLED or USB
char buffer[256];

// Array of DAC values that line up with the 1 V/OCT standard
uint16_t octave[25] = {0, 137, 273, 409, 546, 682, 819, 956, 1092, 1229, 1365, 1501, 1638,
                        1775, 1911, 2048, 2185, 2321, 2458, 2594, 2731, 2867, 3004, 3140, 3277};

// Structure array of all the ADSR pots
// [0] - Attack, [1] - Decay, [2] - Sustain, [3] - Release
ds3502up adsrPots[4] = {{&hi2c3, ADDR1, 0, 0},
                        {&hi2c3, ADDR2, 0, 0},
                        {&hi2c3, ADDR3, 0, 0},
                        {&hi2c3, ADDR4, 0, 0}};

// Structure array of all the tuning pots
// [0] - Coarse1, [1] - Fine1, [2] - Coarse2, [3] - Fine 2
ds3502up tuningPots[4] = {{&hi2c1, ADDR1, 0, 0}, 
                          {&hi2c1, ADDR3, 0, 0},
                          {&hi2c1, ADDR2, 0, 0},
                          {&hi2c1, ADDR4, 0, 0}};

// Structure array of both of the string ADC info
ads7866 strings[2] = {{ADC_CS1_GPIO_Port, ADC_CS1_Pin, &hspi1}, 
                      {ADC_CS2_GPIO_Port, ADC_CS2_Pin, &hspi1}};

// Structure array for both CV outputs 
dacx0501 pitchCV [2] = {{DAC_CS1_GPIO_Port, DAC_CS1_Pin, &hspi2}, 
                        {DAC_CS2_GPIO_Port, DAC_CS2_Pin, &hspi2}};

// Pattern for major and minor keys
// Number corresponds to the number of half steps from root
const uint8_t maj[8] = {0, 2 ,4, 5, 7, 9, 11, 12};
const uint8_t min[8] = {0, 2, 3, 5, 7, 8, 10, 12};

// UI structures
menu oled = {TEST, MAIN, 1, 0, BROWSE};
encoder knob = {0, 0, UP};

// For changing the quantizing mode
scaleMode scale = OCTAVE;

// Current output mode
// mode outputMode = OCTAVE;

/* USER CODE END PV */

void SystemClock_Config(void);
static void MX_GPIO_Init(void);
static void MX_I2C1_Init(void);
static void MX_I2C3_Init(void);
static void MX_SPI1_Init(void);
static void MX_SPI2_Init(void);
static void MX_SPI3_Init(void);
static void MX_TIM2_Init(void);
void userInterface_Init(void const * argument);
void ADC_Init(void const * argument);
void DAC_Init(void const * argument);
void digiPot_Init(void const * argument);
void encoder_Init(void const * argument);

/* USER CODE BEGIN PFP */

// For changing the RGB LED colors
void RGB(uint8_t red, uint8_t green, uint8_t blue);

// Initializes all the required preipherials needed for the application
void PeriphInit(void);

// void USBWrite(unsigned char* msg);

// Shorthand function for sending text to the OLED
void OLEDWrite(char* msg, uint8_t x, uint8_t y);

// Changes the menu to the selected one
void ChangeMenu(page select);

// Maps the given value to descrete steps
uint16_t Map(uint16_t x, int step);
/* USER CODE END PFP */

/**
  * @brief  The application entry point.
  * @retval int
  */
int main(void)
{

  /* MCU Configuration--------------------------------------------------------*/

  /* Reset of all peripherals, Initializes the Flash interface and the Systick. */
  HAL_Init();

  /* Configure the system clock */
  SystemClock_Config();

  /* Initialize all configured peripherals */
  MX_GPIO_Init();
  MX_I2C1_Init();
  MX_I2C3_Init();
  MX_SPI1_Init();
  MX_SPI2_Init();
  MX_SPI3_Init();
  MX_TIM2_Init();
  /* USER CODE BEGIN 2 */

  // Initialize required preipherals
  PeriphInit();

  /* USER CODE END 2 */

  /* USER CODE BEGIN RTOS_MUTEX */
  /* add mutexes, ... */
  /* USER CODE END RTOS_MUTEX */

  /* USER CODE BEGIN RTOS_SEMAPHORES */
  /* add semaphores, ... */
  /* USER CODE END RTOS_SEMAPHORES */

  /* USER CODE BEGIN RTOS_TIMERS */
  /* start timers, add new ones, ... */
  /* USER CODE END RTOS_TIMERS */

  /* USER CODE BEGIN RTOS_QUEUES */
  /* add queues, ... */
  /* USER CODE END RTOS_QUEUES */

  /* Create the thread(s) */
  /* definition and creation of userInterface */
  osThreadDef(userInterface, userInterface_Init, osPriorityNormal, 0, 128);
  userInterfaceHandle = osThreadCreate(osThread(userInterface), NULL);

  /* definition and creation of ADC */
  osThreadDef(ADC, ADC_Init, osPriorityNormal, 0, 128);
  ADCHandle = osThreadCreate(osThread(ADC), NULL);

  /* definition and creation of DAC */
  osThreadDef(DAC, DAC_Init, osPriorityNormal, 0, 128);
  DACHandle = osThreadCreate(osThread(DAC), NULL);

  /* definition and creation of digiPot */
  osThreadDef(digiPot, digiPot_Init, osPriorityNormal, 0, 128);
  digiPotHandle = osThreadCreate(osThread(digiPot), NULL);

  /* definition and creation of encoder */
  osThreadDef(encoder, encoder_Init, osPriorityNormal, 0, 128);
  encoderHandle = osThreadCreate(osThread(encoder), NULL);

  /* Start scheduler */
  osKernelStart();

  /* We should never get here as control is now taken by the scheduler */

  /* Infinite loop */
  /* USER CODE BEGIN WHILE */
  while (1)
  {
    /* USER CODE END WHILE */

    /* USER CODE BEGIN 3 */
  }
  /* USER CODE END 3 */
}

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
/* USER CODE BEGIN 4 */

// Allows the switching of LED pins with one function
// 1 - LED off, 0 - LED on
void RGB(uint8_t red, uint8_t green, uint8_t blue) {
  HAL_GPIO_WritePin(LED_R_GPIO_Port, LED_R_Pin, red);
  HAL_GPIO_WritePin(LED_G_GPIO_Port, LED_G_Pin, green);
  HAL_GPIO_WritePin(LED_B_GPIO_Port, LED_B_Pin, blue);
}

/* void USBWrite(unsigned char* msg) {
  CDC_Transmit_FS(msg, strlen((char*)msg));
} */

void OLEDWrite(char* msg, uint8_t x, uint8_t y) {
  ssd1306_SetCursor(x, y);
  ssd1306_WriteString(msg, FONT, White);
}

void PeriphInit(void) {
  // Turn off all the LEDs
  RGB(1, 1, 1);

  // SPI: Set all the CS pins to High
  HAL_GPIO_WritePin(ADC_CS1_GPIO_Port, ADC_CS1_Pin, GPIO_PIN_SET);
  HAL_GPIO_WritePin(ADC_CS2_GPIO_Port, ADC_CS2_Pin, GPIO_PIN_SET);
  HAL_GPIO_WritePin(DAC_CS1_GPIO_Port, DAC_CS1_Pin, GPIO_PIN_SET);
  HAL_GPIO_WritePin(DAC_CS2_GPIO_Port, DAC_CS2_Pin, GPIO_PIN_SET);
  HAL_GPIO_WritePin(LFO_CS_GPIO_Port, LFO_CS_Pin, GPIO_PIN_SET);

  // Start timer peripheral for counting encoder ticks
  HAL_TIM_Encoder_Start(&htim2, TIM_CHANNEL_ALL);

  // Initialize the OLED for debugging and UI
  ssd1306_Init();

  // Configure the DACs
  ConfDACX051(&pitchCV[0]);
  ConfDACX051(&pitchCV[1]);

  // Get the values the digipots are at
  GetDS3502UP(&tuningPots[COARSE1]);
  GetDS3502UP(&tuningPots[COARSE2]);
  GetDS3502UP(&tuningPots[FINE1]);
  GetDS3502UP(&tuningPots[FINE2]);
  GetDS3502UP(&adsrPots[0]);
  GetDS3502UP(&adsrPots[1]);
  GetDS3502UP(&adsrPots[2]);
  GetDS3502UP(&adsrPots[3]);
}

void ChangeMenu(page select) {
  // Delete previous menu
  ssd1306_Fill(Black);

  // Show the fields of the given menu
  switch (select) {
    case MAIN:  
      OLEDWrite("Tuning", CURSOR_PAD, 0);
      OLEDWrite("ADSR", CURSOR_PAD, 10);
      OLEDWrite("Interface", CURSOR_PAD, 20);
      OLEDWrite("LFO", CURSOR_PAD, 30);
      OLEDWrite("DEBUG", CURSOR_PAD, 40);
      break;

    case TUNE:
      OLEDWrite("BACK", CURSOR_PAD, 0);
      OLEDWrite("Coarse 1", CURSOR_PAD, 10);
      OLEDWrite("Fine 1", CURSOR_PAD, 20);
      OLEDWrite("Coarse 2", CURSOR_PAD, 30);
      OLEDWrite("Fine 2", CURSOR_PAD, 40);
      break;

    case ADSR:
      OLEDWrite("BACK", CURSOR_PAD, 0);
      OLEDWrite("Attack", CURSOR_PAD, 10);
      OLEDWrite("Decay", CURSOR_PAD, 20);
      OLEDWrite("Sustain", CURSOR_PAD, 30);
      OLEDWrite("Release", CURSOR_PAD, 40);
      break;

    case INTERFACE:
      // TODO: Fill interface parameter menu up with
      // nice-to-have features (Like Root note selection)
      OLEDWrite("BACK", CURSOR_PAD, 0);
      OLEDWrite("Mode", CURSOR_PAD, 10);
      OLEDWrite("-", CURSOR_PAD, 20);
      OLEDWrite("-", CURSOR_PAD, 30);
      OLEDWrite("-", CURSOR_PAD, 40);
      break;

    case LFO:
      // TODO: Fill LFO parameter menu up when driver is
      // ready to be tested
      OLEDWrite("BACK", CURSOR_PAD, 0);
      OLEDWrite("-", CURSOR_PAD, 10);
      OLEDWrite("-", CURSOR_PAD, 20);
      OLEDWrite("-", CURSOR_PAD, 30);
      OLEDWrite("-", CURSOR_PAD, 40);
      break;

    case TEST:
      // This menu is left intentionally blank to be able to
      // fill with any values you would want to debug
      OLEDWrite("BACK", CURSOR_PAD, 0);
      break;
  }
  ssd1306_UpdateScreen();

  oled.currentMenu = select;
}


uint16_t Map(uint16_t x, int step) {
	// x * step / (MEMBRANE_MAX - MEMBRANE_MAX) + out_min;
	return (x - MEMBRANE_MIN) * step / (MEMBRANE_MAX - MEMBRANE_MIN);

  /*
  // Normalize to 0–1
  double t = (x - MEMBRANE_MIN) / (MEMBRANE_MAX - MEMBRANE_MIN);

  // Clamp (important for safety)
  if (t < 0.0) t = 0.0;
  if (t > 1.0) t = 1.0;

  // Apply exponential curve
  double y = step * (t * (1.5 - 0.5 * t));

  // Convert to integer (choose one)
  return (uint16_t)(y + 0.5);  // round to nearest */
}

/* USER CODE END 4 */

/* USER CODE BEGIN Header_userInterface_Init */
/**
  * @brief  Function implementing the userInterface thread.
  * @param  argument: Not used
  * @retval None
  */
/* USER CODE END Header_userInterface_Init */
void userInterface_Init(void const * argument)
{
  /* init code for USB_DEVICE */
  MX_USB_DEVICE_Init();
  /* USER CODE BEGIN 5 */

  /* Infinite loop */
  for(;;) 
  {
    switch (oled.state) {
      case BROWSE:
        if (oled.currentMenu == TEST) {
          // Show debugging info on OLED

          // ADC value
          sprintf(buffer, "Str: %4d, %4d\n\r", strings[0].value, strings[1].value);
          OLEDWrite(buffer, CURSOR_PAD, 10);
          // DAC value
          sprintf(buffer, "DAC: %5d, %2d", pitchCV[1].currentValue >> 4, Map(strings[0].value, 18));
          OLEDWrite(buffer, CURSOR_PAD, 20);
        }

        if (oled.previousMenu != oled.currentMenu) {
          // Update the OLED to the new menu
          ChangeMenu(oled.currentMenu);

          // Delete any and all cursors
          ssd1306_FillRectangle(0, 0, CURSOR_PAD, OLED_HEIGHT, Black);

          if (oled.currentMenu == MAIN) {
            // Returning to the main page will set the cursor to the position of the previous menu
            ssd1306_FillCircle(5, 5 + 10 * (oled.previousMenu - 1), 3, White);
            // oled.selectionIndex = oled.previousMenu - 1;
          }
          else {
            // Othewise the cursor will be placed on the first selection
            ssd1306_FillCircle(5, 5, 3, White);
            oled.selectionIndex = 0;
          }
          // Update the previous menu field to the current one
          // So that the previous logic can be made again
          oled.previousMenu = oled.currentMenu;
        }

        // Logic for displaying the cursor position
        if (oled.previousIndex != oled.selectionIndex) {

          // Delete any and all cursors
          ssd1306_FillRectangle(0, 0, CURSOR_PAD, OLED_HEIGHT, Black);
          
          // Make a new cursor at the selection index
          ssd1306_FillCircle(5, 5 + 10 * oled.selectionIndex, 3, White);
          
          // Set the previous indec to the current one
          // So that the previous logic can be made again
          oled.previousIndex = oled.selectionIndex;
        }

        ssd1306_UpdateScreen();
        break;

      case EDIT:
        switch (oled.currentMenu) {
          case TUNE:
            // Restrict the parameter value between 127 and 0, because
            // the DS3502U+ chips are 7-bit (0 - 0x7F)
            if (knob.parameterValueModifier > 0x7F)
              knob.parameterValueModifier = 0x7F;

            else if (knob.parameterValueModifier < 0)
              knob.parameterValueModifier = 0;

            // Display editable value 
            sprintf(buffer, "%3ld", knob.parameterValueModifier);
            OLEDWrite(buffer, 100, 10 * oled.selectionIndex);
            ssd1306_UpdateScreen();

            tuningPots[oled.selectionIndex - 1].newValue = knob.parameterValueModifier;
            break;
          case ADSR:
            // Restrict the parameter value between 127 and 0, because
            // the DS3502U+ chips are 7-bit (0 - 0x7F)
            if (knob.parameterValueModifier > 0x7F)
              knob.parameterValueModifier = 0x7F;

            else if (knob.parameterValueModifier < 0)
              knob.parameterValueModifier = 0;

            // Display editable value 
            sprintf(buffer, "%3ld", knob.parameterValueModifier);
            OLEDWrite(buffer, 100, 10 * oled.selectionIndex);
            ssd1306_UpdateScreen();

            adsrPots[oled.selectionIndex - 1].newValue = knob.parameterValueModifier;
            break;
          case INTERFACE:
            if (knob.parameterValueModifier > 3)
              knob.parameterValueModifier = 3;

            else if (knob.parameterValueModifier < 0)
              knob.parameterValueModifier = 0;

            scale = knob.parameterValueModifier;

            // Display editable value
            switch (scale) {
              case OCTAVE:
                OLEDWrite("OCT", 100, 10 * oled.selectionIndex);
                break;
              case OCTAVE2:
                OLEDWrite("OCT2", 100, 10 * oled.selectionIndex);
                break;
              case MAJOR:
                OLEDWrite("MAJ", 100, 10 * oled.selectionIndex);
                break;
              case MINOR:
                OLEDWrite("MIN", 100, 10 * oled.selectionIndex);
                break;
            }
            ssd1306_UpdateScreen();

            break;
          case LFO:
            // TODO: Integrate LFO library with code
            break;
          default:
            break;
        }
        break;
    }
  }
  /* USER CODE END 5 */
}

/* USER CODE BEGIN Header_ADC_Init */
/**
* @brief Function implementing the ADC thread.
* @param argument: Not used
* @retval None
*/
/* USER CODE END Header_ADC_Init */
void ADC_Init(void const * argument)
{
  /* USER CODE BEGIN ADC_Init */
  /* Infinite loop */
  for(;;)
  {
    // Constantly poll for new user input values
    GetADS7866(&strings[0]);
    GetADS7866(&strings[1]);
    osDelay(1);
  }
  /* USER CODE END ADC_Init */
}

/* USER CODE BEGIN Header_DAC_Init */
/**
* @brief Function implementing the DAC thread.
* @param argument: Not used
* @retval None
*/
/* USER CODE END Header_DAC_Init */
void DAC_Init(void const * argument)
{
  /* USER CODE BEGIN DAC_Init */
  uint8_t steps, currentStep0, currentStep1;
  /* Infinite loop */
  for(;;)
  {
    // Change the amount of steps
    switch (scale) {
      case OCTAVE: // 12 notes in an octave
        steps = 12;
        break;
      case OCTAVE2: // 24 in two octaves
        steps = 24;
        break;
      case MAJOR: // Major and minor have 7 notes (3 octaves)
      case MINOR:
        steps = 18;
        break;
    }
    // Get the steps the inputs are at
    currentStep0 = Map(strings[1].value, steps);
    currentStep1 = Map(strings[0].value, steps);

    // Major/minor do not have an equal distance between notes
    // so they need special consideration
    if (scale == MAJOR) {
      // Dividing by 7 rounds down to the nearest int and gets which octave it's in
      // Module 6 gets which note in the scale has been chosen
      pitchCV[0].newValue = ((uint8_t)(currentStep0 / 7) * DAC_OCTAVE) + (maj[currentStep0 % 7] * DAC_HALFSTEP);
      pitchCV[1].newValue = ((uint8_t)(currentStep1 / 7) * DAC_OCTAVE) + (maj[currentStep1 % 7] * DAC_HALFSTEP);
    }
    else if (scale == MINOR) {
      // Dividing by 7 rounds down to the nearest int and gets which octave it's in
      // Module 6 gets which note in the scale has been chosen
      pitchCV[0].newValue = ((uint8_t)(currentStep0 / 7) * DAC_OCTAVE) + (min[currentStep0 % 7] * DAC_HALFSTEP);
      pitchCV[1].newValue = ((uint8_t)(currentStep1 / 7) * DAC_OCTAVE) + (min[currentStep1 % 7] * DAC_HALFSTEP);
    }
    else {
      pitchCV[0].newValue = octave[currentStep0];
      pitchCV[1].newValue = octave[currentStep1];
    }

    
    // Don't change the value of the DAC unless it has changed
    if (pitchCV[0].currentValue != pitchCV[0].newValue)
      SetDACX0501(&pitchCV[0]);

    if (pitchCV[1].currentValue != pitchCV[1].newValue)
      SetDACX0501(&pitchCV[1]);

    osDelay(1);
  }
  /* USER CODE END DAC_Init */
}

/* USER CODE BEGIN Header_digiPot_Init */
/**
* @brief Function implementing the digiPot thread.
* @param argument: Not used
* @retval None
*/
/* USER CODE END Header_digiPot_Init */
void digiPot_Init(void const * argument)
{
  /* USER CODE BEGIN digiPot_Init */
  /* Infinite loop */
  for(;;)
  { 
    // Don't change the potentiometer values unless the value has been changed
    // Coarse1
    if (tuningPots[COARSE1].newValue != tuningPots[COARSE1].currentValue)
      SetDS3502UP(&tuningPots[COARSE1]);

    // Coarse2
    if (tuningPots[COARSE2].newValue != tuningPots[COARSE2].currentValue)
      SetDS3502UP(&tuningPots[COARSE2]);

    // Fine1
    if (tuningPots[FINE1].newValue != tuningPots[FINE1].currentValue)
      SetDS3502UP(&tuningPots[FINE1]);

    // Fine2
    if (tuningPots[FINE2].newValue != tuningPots[FINE2].currentValue)
      SetDS3502UP(&tuningPots[FINE2]);

    
    // Attack
    if (adsrPots[0].newValue != adsrPots[0].currentValue)
      SetDS3502UP(&adsrPots[0]);

    // Decay
    if (adsrPots[1].newValue != adsrPots[1].currentValue)
      SetDS3502UP(&adsrPots[1]);

    // Sustain
    if (adsrPots[2].newValue != adsrPots[2].currentValue)
      SetDS3502UP(&adsrPots[2]);

    // Release
    if (adsrPots[3].newValue != adsrPots[3].currentValue)
      SetDS3502UP(&adsrPots[3]);
    
    osDelay(1);
  }
  /* USER CODE END digiPot_Init */
}

/* USER CODE BEGIN Header_encoder_Init */
/**
* @brief Function implementing the encoder thread.
* @param argument: Not used
* @retval None
*/
/* USER CODE END Header_encoder_Init */
void encoder_Init(void const * argument)
{
  /* USER CODE BEGIN encoder_Init */
  uint32_t currentCounterValue;
  uint8_t pressed = 0;
  
  /* Infinite loop */
  for(;;)
  {
    currentCounterValue = (TIM2->CNT) >> 1;

    if (currentCounterValue != knob.lastCounterValue) {
      // Get whether the direction bit of the ControlRegister1 indicates
      // an up or down movement
      knob.dir = (TIM2->CR1 & TIM_CR1_DIR) ? DOWN: UP;

      switch (oled.state) {
        // Mode where you're navigating the menus
        case BROWSE:
          // Based on whether the direction was down or up, change the 
          // selection index accordingly
          if (knob.dir == UP) {
            if (oled.selectionIndex + 1 <= MENU_IDX_MAX)
              oled.selectionIndex++;
          }
          else {
            if (oled.selectionIndex - 1 >= 0)
              oled.selectionIndex--;
          }
          break;

        // Mode where you're changing the parameter value
        case EDIT:
          if (knob.dir == UP) 
            knob.parameterValueModifier++;
          else
            knob.parameterValueModifier--;
          break;
      }

      knob.lastCounterValue = currentCounterValue;
    }

    if (HAL_GPIO_ReadPin(ENC_SW_GPIO_Port, ENC_SW_Pin) && !pressed) {
      // In the main menu, clicking the encoder changes menu to the
      // according index
      if (oled.currentMenu == MAIN) {
        oled.currentMenu = oled.selectionIndex + 1; // +1, because index 0 is MAIN
      }

      else {
        // The first selection of each submenu is the BACK button
        // which takes you to the MAIN menu
        if (oled.selectionIndex == 0) {
          oled.currentMenu = MAIN;
        }

        else {
          // Set the beginning value for the given parameter(s) that have NVMemory
          switch (oled.currentMenu) {
            case TUNE:
              knob.parameterValueModifier = tuningPots[oled.selectionIndex - 1].currentValue;
              break;
            case ADSR:
              knob.parameterValueModifier = adsrPots[oled.selectionIndex - 1].currentValue;
              break;
            default:
              knob.parameterValueModifier = 0;
              break;
          }

          // Delete anything that might've been at the end sector of the OLED
          ssd1306_FillRectangle(100, 0, 128, 64, Black);
          
          // Toggle the state from BROWSE to EDIT or vice versa
          oled.state ^= EDIT;
        }
      }
      // Latch the pressed value to 1 so that it doesn't keep toggling
      pressed = 1;
    }
    else if (!HAL_GPIO_ReadPin(ENC_SW_GPIO_Port, ENC_SW_Pin)) {
      // Unlatch the button press
      pressed = 0;
    }
    
    osDelay(1);
  }
  /* USER CODE END encoder_Init */
}

/**
  * @brief  Period elapsed callback in non blocking mode
  * @note   This function is called  when TIM1 interrupt took place, inside
  * HAL_TIM_IRQHandler(). It makes a direct call to HAL_IncTick() to increment
  * a global variable "uwTick" used as application time base.
  * @param  htim : TIM handle
  * @retval None
  */
void HAL_TIM_PeriodElapsedCallback(TIM_HandleTypeDef *htim)
{
  if (htim->Instance == TIM1)
  {
    HAL_IncTick();
  }
}

/**
  * @brief  This function is executed in case of error occurrence.
  * @retval None
  */
void Error_Handler(void)
{
  /* USER CODE BEGIN Error_Handler_Debug */
  /* User can add his own implementation to report the HAL error return state */
  __disable_irq();
  while (1)
  {
  }
  /* USER CODE END Error_Handler_Debug */
}
#ifdef USE_FULL_ASSERT
/**
  * @brief  Reports the name of the source file and the source line number
  *         where the assert_param error has occurred.
  * @param  file: pointer to the source file name
  * @param  line: assert_param error line source number
  * @retval None
  */
void assert_failed(uint8_t *file, uint32_t line)
{
  /* USER CODE BEGIN 6 */
  /* User can add his own implementation to report the file name and line number,
     ex: printf("Wrong parameters value: file %s on line %d\r\n", file, line) */
  /* USER CODE END 6 */
}
#endif /* USE_FULL_ASSERT */
