RamsesKlap/FinalThesis/(commit log)

2025-04-27 Init. commit
    [Interface.kicad_sch, LQFP100-14x14mm.step, MCU.kicad_sch, ModulinV2.kicad_pcb, ModulinV2.kicad_sch]
2025-05-26 Added initial schematic and components for interface
    [Interface.kicad_sch, MCU.kicad_sch, ModulinV2.kicad_sch]
2025-06-18 Semi-finished interface schematic
    [Interface.kicad_sch, ModulinV2.kicad_sch]
2025-06-19 Added CubeIDE folder and mapped out initial SPI pins
    [Interface.kicad_sch, MCU.kicad_sch, ModulinV2.kicad_sch]
2025-07-08 Added initial schematic of VCO and repaired some schematic issues
    [Interface.kicad_sch, LQFP100-14x14mm.step, MCU.kicad_sch, ModulinV2.kicad_pcb, ModulinV2.kicad_sch, OctaveSelect.kicad_sch, VCO.kicad_sch]
2025-07-14 Finished 1.0 of the VCO and started making the waveform select module
    [Interface.kicad_sch, MCU.kicad_sch, ModulinV2.kicad_sch, VCO.kicad_sch, WaveformSelect.kicad_sch]
2025-07-16 Made initial AS3360 VCA schematic
    [ModulinV2.kicad_sch, VCA.kicad_sch]
2025-07-26 Modified Octave selector and started on waveform selection
    [ModulinV2.kicad_sch, OctaveSelect.kicad_sch, VCA.kicad_sch, VCO.kicad_sch, WaveformSelect.kicad_sch]
2025-08-04 Modified USB connection and added LEDs
    [Interface.kicad_sch, MCU.kicad_sch, ModulinV2.kicad_sch, OctaveSelect.kicad_sch, Power.kicad_sch, VCA.kicad_sch, VCO.kicad_sch, WaveformSelect.kicad_sch]
2025-08-05 Fleshed out the waveform select schematic a bit + general cleanup
    [Interface.kicad_sch, MCU.kicad_sch, ModulinV2.kicad_sch, OctaveSelect.kicad_sch, VCA.kicad_sch, VCO.kicad_sch, WaveformSelect.kicad_sch]
2025-08-11 Added initial power supply schematic and modified MCU components
    [MCU.kicad_sch, ModulinV2.kicad_sch, OctaveSelect.kicad_sch, VCA.kicad_sch, VCO.kicad_sch, WaveformSelect.kicad_sch, powersupply.kicad_sch]
2025-08-18 Designed ADSR and better tuning schematics with digital/manual capability
    [ADSR.kicad_sch, Interface.kicad_sch, MCU.kicad_sch, ModulinV2.kicad_sch, OctaveSelect.kicad_sch, SelectionUI.kicad_sch, Tuning.kicad_sch, VCA.kicad_sch]
2025-08-18 Added 4k7 pullups to I2C lines
    [ADSR.kicad_sch, Interface.kicad_sch, MCU.kicad_sch, ModulinV2.kicad_sch, OctaveSelect.kicad_sch, SelectionUI.kicad_sch, Tuning.kicad_sch, VCA.kicad_sch]
2025-08-18 Found and added linear slide pot meant for pitch bending
    [ADSR.kicad_sch, ModulinV2.kicad_sch]
2025-08-20 Modified supply schematic and made modulation wheel initial design
    [ModulinV2.kicad_sch, powersupply.kicad_sch]
2025-08-27 Modified selection LED schematic and supply caps
    [ADSR.kicad_sch, Interface.kicad_sch, MCU.kicad_sch, ModulinV2.csv, ModulinV2.kicad_sch, OctaveSelect.kicad_sch, SelectionUI.kicad_sch, VCA.kicad_sch]
2025-08-29 Revert "Modified selection LED schematic and supply caps"
    This reverts commit f7ca9d31056dcb2cadf4048ae59e1f5625a2aefa.
    [ADSR.kicad_sch, Interface.kicad_sch, MCU.kicad_sch, ModulinV2.csv, ModulinV2.kicad_sch, OctaveSelect.kicad_sch, SelectionUI.kicad_sch, VCA.kicad_sch]
2025-08-29 Added wave selection jumpers for testing
    [ADSR.kicad_sch, Interface.kicad_sch, MCU.kicad_sch, ModulinV2.csv, ModulinV2.kicad_sch, OctaveSelect.kicad_sch, SelectionUI.kicad_sch, VCA.kicad_sch]
2025-08-29 Updated TL074 and 72 symbols
    [ADSR.kicad_sch, Interface.kicad_sch, ModulinV2.kicad_sch, OctaveSelect.kicad_sch, Tuning.kicad_sch, VCA.kicad_sch, VCO.kicad_sch]
2025-08-29 Added L7812 regulators as backup power supply option
    [powersupply.kicad_sch]
2025-08-29 Added fuse and polarity protection to supply schematic
    [powersupply.kicad_sch]
2025-08-30 Fixed library issues and assigned most footprints
    [ADSR.kicad_sch, Interface.kicad_sch, MCU.kicad_sch, ModulinV2.kicad_sch, OctaveSelect.kicad_sch, SelectionUI.kicad_sch, Tuning.kicad_sch, VCA.kicad_sch]
2025-09-01 Changed switch for the boot and nrst. Fixed the GATE interface trigger
    [ADSR.kicad_sch, Interface.kicad_sch, MCU.kicad_sch, ModulinV2.kicad_sch, OctaveSelect.kicad_sch, SelectionUI.kicad_sch, Tuning.kicad_sch, VCA.kicad_sch]
2025-09-03 Designed the schmitt triger (finally)
    [Interface.kicad_sch, LFO.kicad_sch, ModulinV2.kicad_sch]
2025-09-03 Started adding footprints for capacitors
    [ADSR.kicad_sch, Interface.kicad_sch, MCU.kicad_sch, ModulinV2.csv, ModulinV2.kicad_sch, OctaveSelect.kicad_sch, SelectionUI.kicad_sch, Tuning.kicad_sch]
2025-09-08 Added footprints to all capacitors and potentiometers
    [ADSR.kicad_sch, Interface.kicad_sch, MCU.kicad_sch, ModulinV2.csv, ModulinV2.kicad_sch, OctaveSelect.kicad_sch, SelectionUI.kicad_sch, Tuning.kicad_sch]
2025-09-12 Made LFO and VCF schematics in addition to making a better reference voltage supply
    [ADSR.kicad_sch, LFO.kicad_sch, MCU.kicad_sch, ModulinV2.csv, ModulinV2.kicad_sch, ModulinV2_amounts.csv, VCF.kicad_sch, powersupply.kicad_sch]
2025-09-14 Finished Schematic, started on PCB
    [ADSR.kicad_sch, Interface.kicad_sch, LFO.kicad_sch, MCU.kicad_sch, ModulinV2.kicad_pcb, ModulinV2.kicad_sch, ModulinV2_amounts2.csv, OctaveSelect.kicad_sch]
2025-09-15 Started designing the power supply layout and grouped components by the type of circuit
    [LFO.kicad_sch, ModulinV2.kicad_pcb, ModulinV2.kicad_sch, VCF.kicad_sch, powersupply.kicad_sch]
2025-09-21 Layed out Interface and PWR components and started with MCU layout
    [ADSR.kicad_sch, Interface.kicad_sch, LFO.kicad_sch, MCU.kicad_sch, ModulinV2.kicad_pcb, OctaveSelect.kicad_sch, SelectionUI.kicad_sch, Tuning.kicad_sch]
2025-09-22 Decided to make everything one sided and not care about layout as much
    [ModulinV2.kicad_pcb]
2025-09-22 Continued designing the MCU schematic
    [MCU.kicad_sch, ModulinV2.kicad_pcb]
2025-09-23 Finished routing MCU schematic, started with tuning
    [Tuning.kicad_sch]
2025-09-23 Completed tuning & mod wheel layouts
    [ADSR.kicad_sch, Interface.kicad_sch, LFO.kicad_sch, MCU.kicad_sch, ModulinV2.kicad_sch, OctaveSelect.kicad_sch, SelectionUI.kicad_sch, Tuning.kicad_sch]
2025-09-25 Completed VCF and VCA layouts, started with ADSR
    [ADSR.kicad_sch]
2025-09-27 Completed ADSR layout, started with Waveform select
    [ADSR.kicad_sch, ModulinV2.kicad_sch, WaveformSelect.kicad_sch]
2025-09-28 FInished LFO, octave/wave selector and UI layout
    [OctaveSelect.kicad_sch, SelectionUI.kicad_sch]
2025-09-29 Layed out all components, started with power routing
2025-10-13 Fixed some configuration issues and started writing functions for the ADS7041 library
    [ModulinV2-B_Cu.gbl, ModulinV2-B_Mask.gbs, ModulinV2-B_Paste.gbp, ModulinV2-B_Silkscreen.gbo, ModulinV2-Edge_Cuts.gm1, ModulinV2-F_Cu.gtl, ModulinV2-F_Mask.gts, ModulinV2-F_Paste.gtp]
2025-10-16 Started fiddling with FreeRTOS, made the setups in CubeMX
    [VCO.kicad_sch]
2025-10-27 Fixed digipot library. It works now
    [DACx0501.h, DS3502UP.c, DS3502UP.h, ModulinV2.ioc, main.c]
2025-11-08 Got DAC driver working
2025-11-08 Before I start changing the ADC driver to the slower ADC, because the last one wasn't working
2025-11-08 Fixed ADC code on new chip
    [ModulinV2.ioc, main.c]
2025-11-17 Cleaned up test code and ADC driver. Starting with code structure
2025-11-17 Fixed the naming of the ADC library
2025-11-17 Forgot to change the return type for ADC lib
2025-11-17 Fleshed out the UI a bit more and added initial structures to ADC, DAC and digipot threads
2025-11-18 Not satisfied with the current solution for the menu. Gonna start again
2025-11-21 Fixed Digipot library so that you can actually get the wiper value
    [DS3502UP.c, ModulinV2.ioc, main.c]
2025-11-27 Logic for sending output CV in relation to input voltage is working
2026-02-07 Added folders for LFO dac driver
2026-03-18 Added oscilloscope images of jitter+trigger speed
    [main.c]
2026-04-26 fixed Major & Minor scaling issues
    [main.c]
2026-04-29 Fixed schematic connections
    [ADSR.kicad_sch, Interface.kicad_sch, LFO.kicad_sch, MCU.kicad_sch, ModulinV2.kicad_sch, OctaveSelect.kicad_sch, SelectionUI.kicad_sch, Tuning.kicad_sch]
2026-04-29 Removed redundant files and added schematic pdf
    [ModulinV2-B_Cu.gbl, ModulinV2-B_Mask.gbs, ModulinV2-B_Paste.gbp, ModulinV2-B_Silkscreen.gbo, ModulinV2-Edge_Cuts.gm1, ModulinV2-F_Cu.gtl, ModulinV2-F_Mask.gts, ModulinV2-F_Paste.gtp]
2026-05-05 Fixed ribbon controller scaling issue
    [main.c]
